mbouyer/weatherstation/hardware/images/vetus.jpg

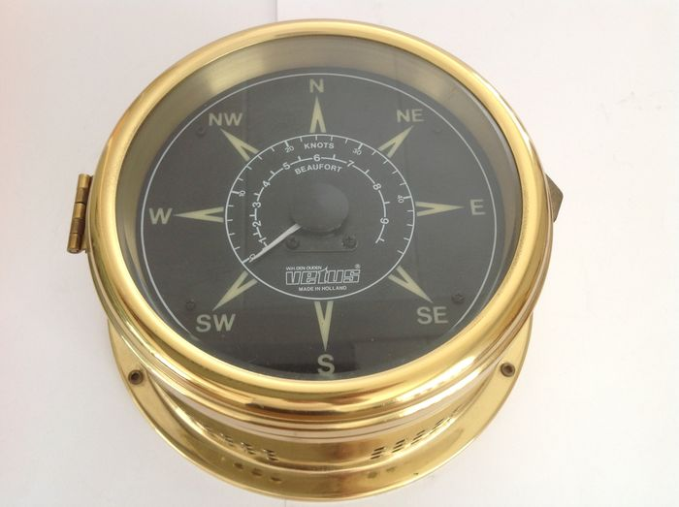
hardware/images/vetus.jpg
