mbouyer/weatherstation/README.md

# weatherstation
A home weather station with internet connectivity
