mbouyer/weatherstation/software/weewx/n2k_driver/readme.txt

n2k_driver - a driver monitoring a CAN bus
Copyright 2021 Manuel BOUYER
