mbouyer/weatherstation/hardware/capteur/CAD/1555CGY-pcb.dxf

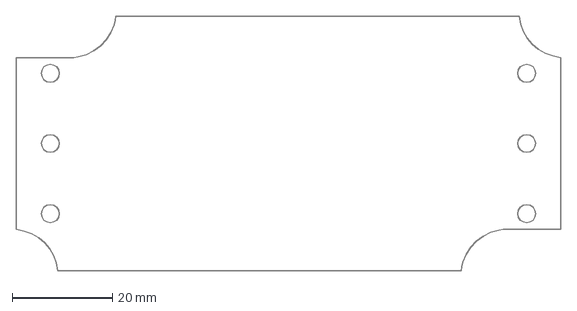
[picture p2: CAD file, 2022-03-15]
hardware/capteur/CAD/1555CGY-pcb.dxf
108.5 x 50.8 mm
