mbouyer/weatherstation/hardware/centrale/CAD/display-lock.stl

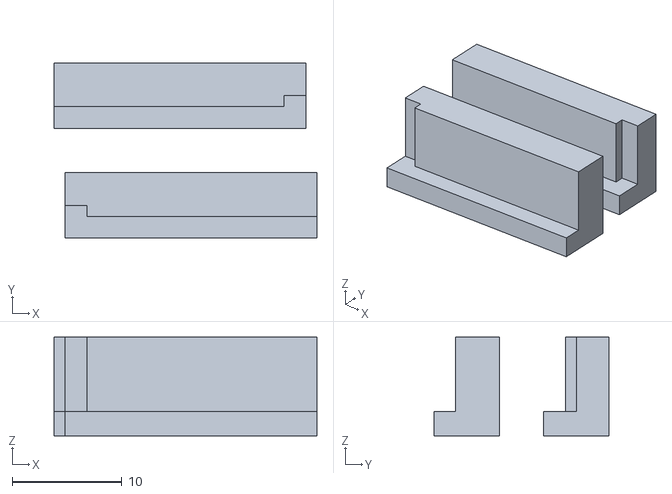
[picture p3: CAD file, 2022-04-14]
hardware/centrale/CAD/display-lock.stl
24.0 x 16.0 x 9.00
