mbouyer/weatherstation/hardware/coupleur/CAD/RX2007_S-5.dxf

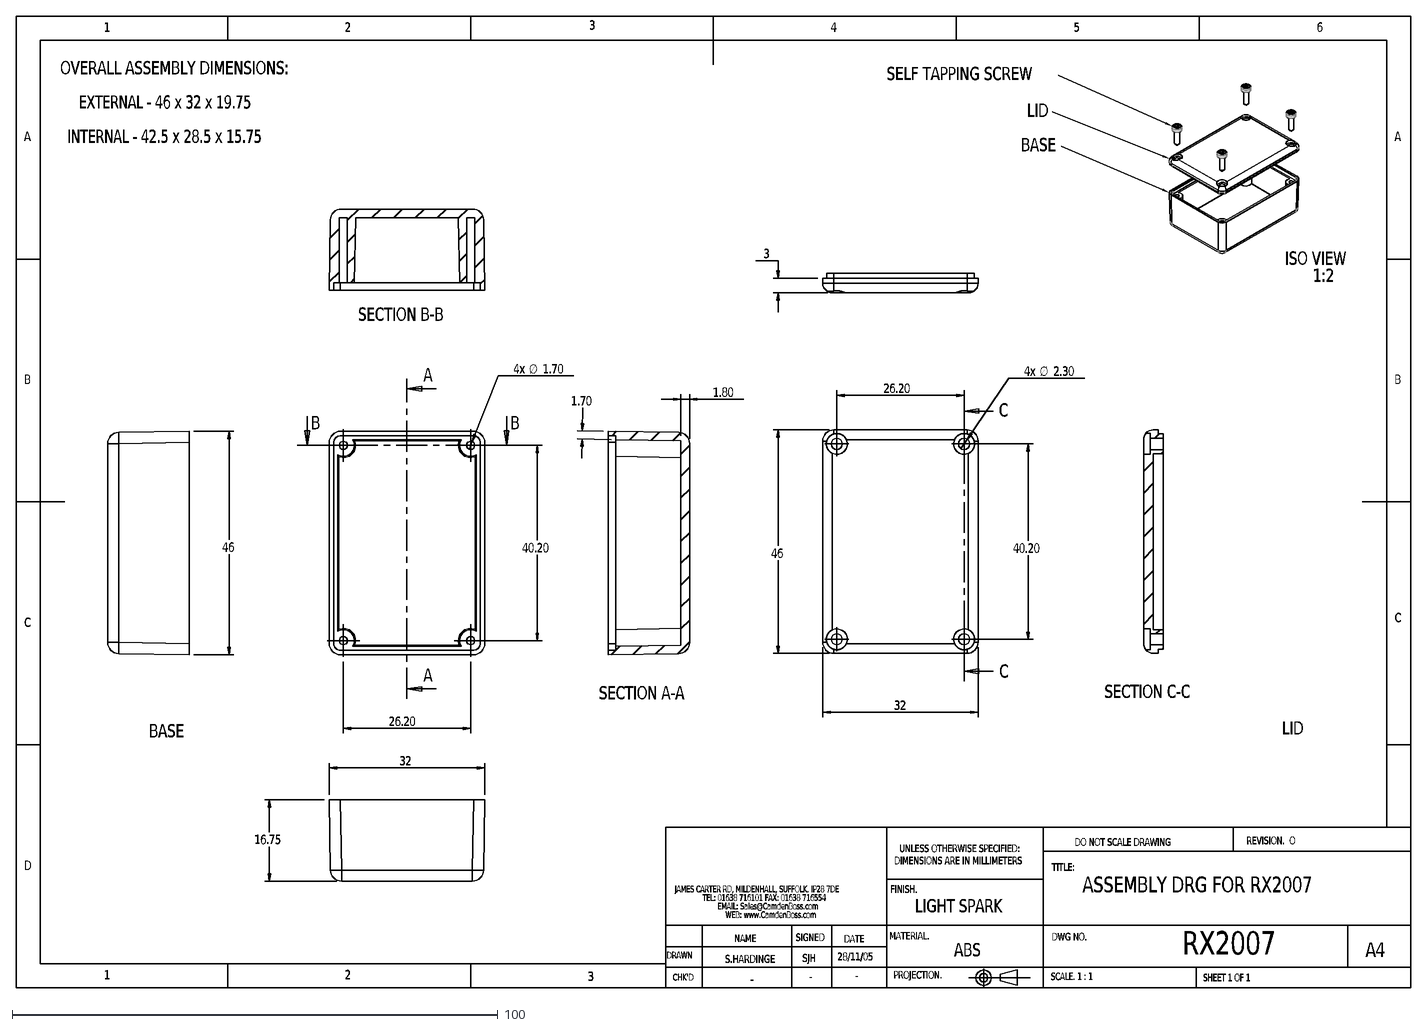
[picture p4: CAD file, 2021-04-18]
hardware/coupleur/CAD/RX2007_S-5.dxf
B
C
D
1
2
A
4
5
6
DRAWN
CHK'D
UNLESS OTHERWISE SPECIFIED:
DIMENSIONS ARE IN MILLIMETERS
FINISH.
NAME
SIGNED
DATE
MATERIAL.
DO NOT SCALE DRAWING
TITLE:
DWG NO.
SCALE. 1 : 1
SHEET 1 OF 1
A4
PROJECTION.
REVISION. O
RX2007
LIGHT SPARK
ABS
28/11/05
SJH
S.HARDINGE
-
ASSEMBLY DRG FOR RX2007
3
JAMES CARTER RD, MILDENHALL, SUFFOLK. IP28 7DE
TEL: 01638 716101 FAX: 01638 716554
EMAIL: Sales@CamdenBoss.com
WEB: www.CamdenBoss.com
40.20
4x
∅
1.70
26.20
16.75
32
46
BASE
2.30
1.80
SECTION A-A
SECTION B-B
OVERALL ASSEMBLY DIMENSIONS:
EXTERNAL - 46 x 32 x 19.75
INTERNAL - 42.5 x 28.5 x 15.75
SECTION C-C
LID
ISO VIEW
1:2
SELF TAPPING SCREW
