mbouyer/weatherstation/hardware/power/CAD/pcb.dxf

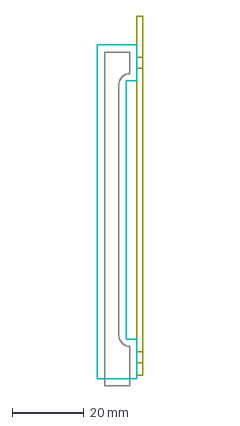
[picture p5: CAD file, 2021-05-04]
hardware/power/CAD/pcb.dxf
12.6 x 103.0 mm
