mbouyer/weatherstation/hardware/capteur/CAD/1555CGY-couvercle.dxf

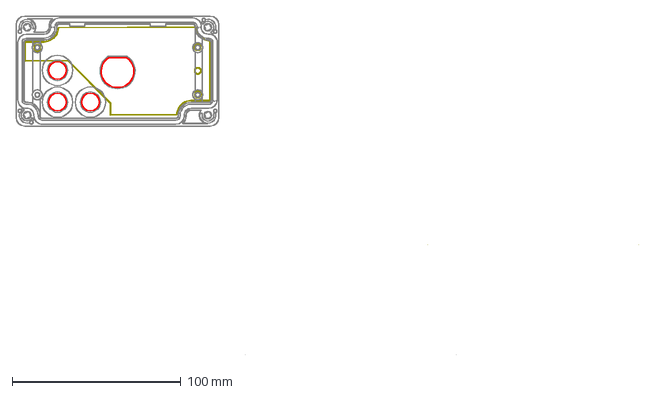
[picture p6: CAD file, 2021-05-07]
hardware/capteur/CAD/1555CGY-couvercle.dxf
368.6 x 200.4 mm
