mbouyer/weatherstation/hardware/centrale/CAD/display.stl

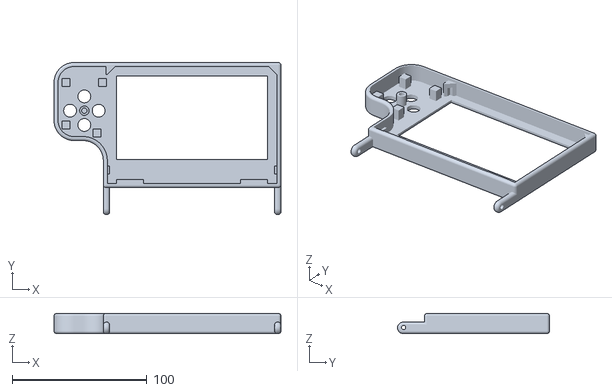
[picture p7: CAD file, 2022-04-13]
hardware/centrale/CAD/display.stl
168.6 x 112.9 x 15.0
