mbouyer/weatherstation/hardware/coupleur/CAD/RX2007_S-5-board.dxf

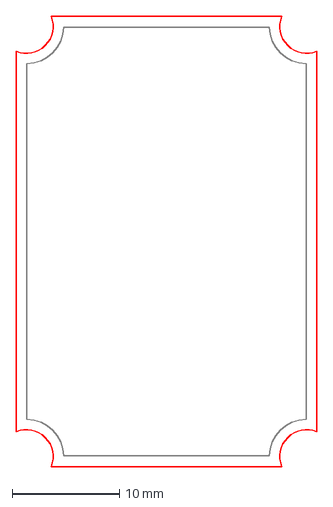
[picture p8: CAD file, 2021-04-18]
hardware/coupleur/CAD/RX2007_S-5-board.dxf
28.1 x 42.1 mm
