mbouyer/weatherstation/hardware/power/CAD/base.dxf

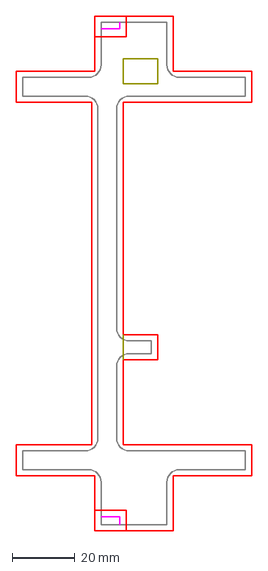
[picture p9: CAD file, 2021-05-04]
hardware/power/CAD/base.dxf
75.0 x 164.0 mm
