mbouyer/weatherstation/hardware/capteur/CAD/support-thermo-fn100.stl

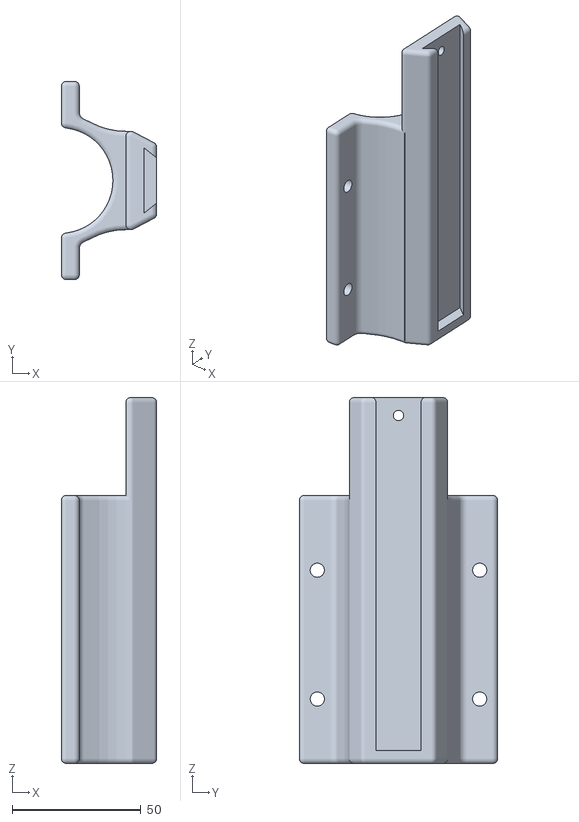
[picture p10: CAD file, 2021-04-18]
hardware/capteur/CAD/support-thermo-fn100.stl
37.0 x 77.0 x 142.0
