mbouyer/weatherstation/hardware/centrale/CAD/pcb.stl

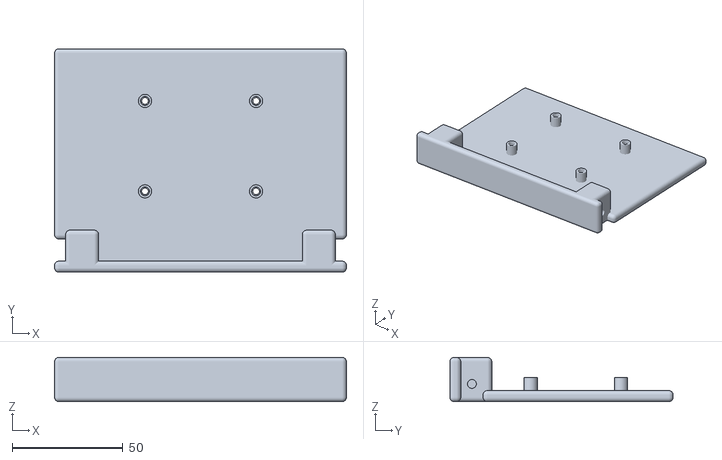
[picture p11: CAD file, 2022-04-11]
hardware/centrale/CAD/pcb.stl
132.0 x 101.0 x 20.0
