mbouyer/weatherstation/hardware/capteur/CAD/support-pluvio-fa30_10.stl

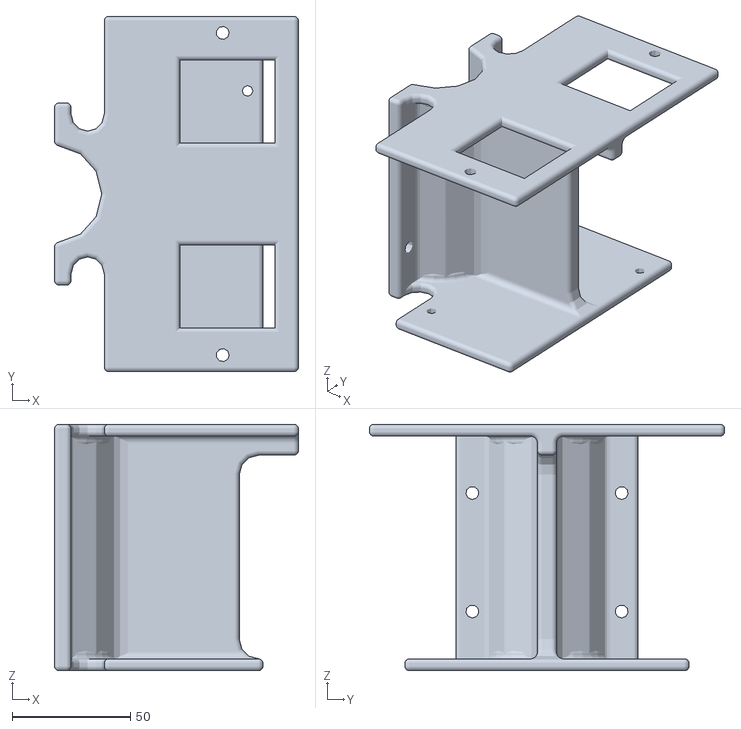
[picture p12: CAD file, 2021-04-18]
hardware/capteur/CAD/support-pluvio-fa30_10.stl
103.0 x 150.0 x 104.0
