mbouyer/weatherstation/hardware/centrale/CAD/PCB-mesures.dxf

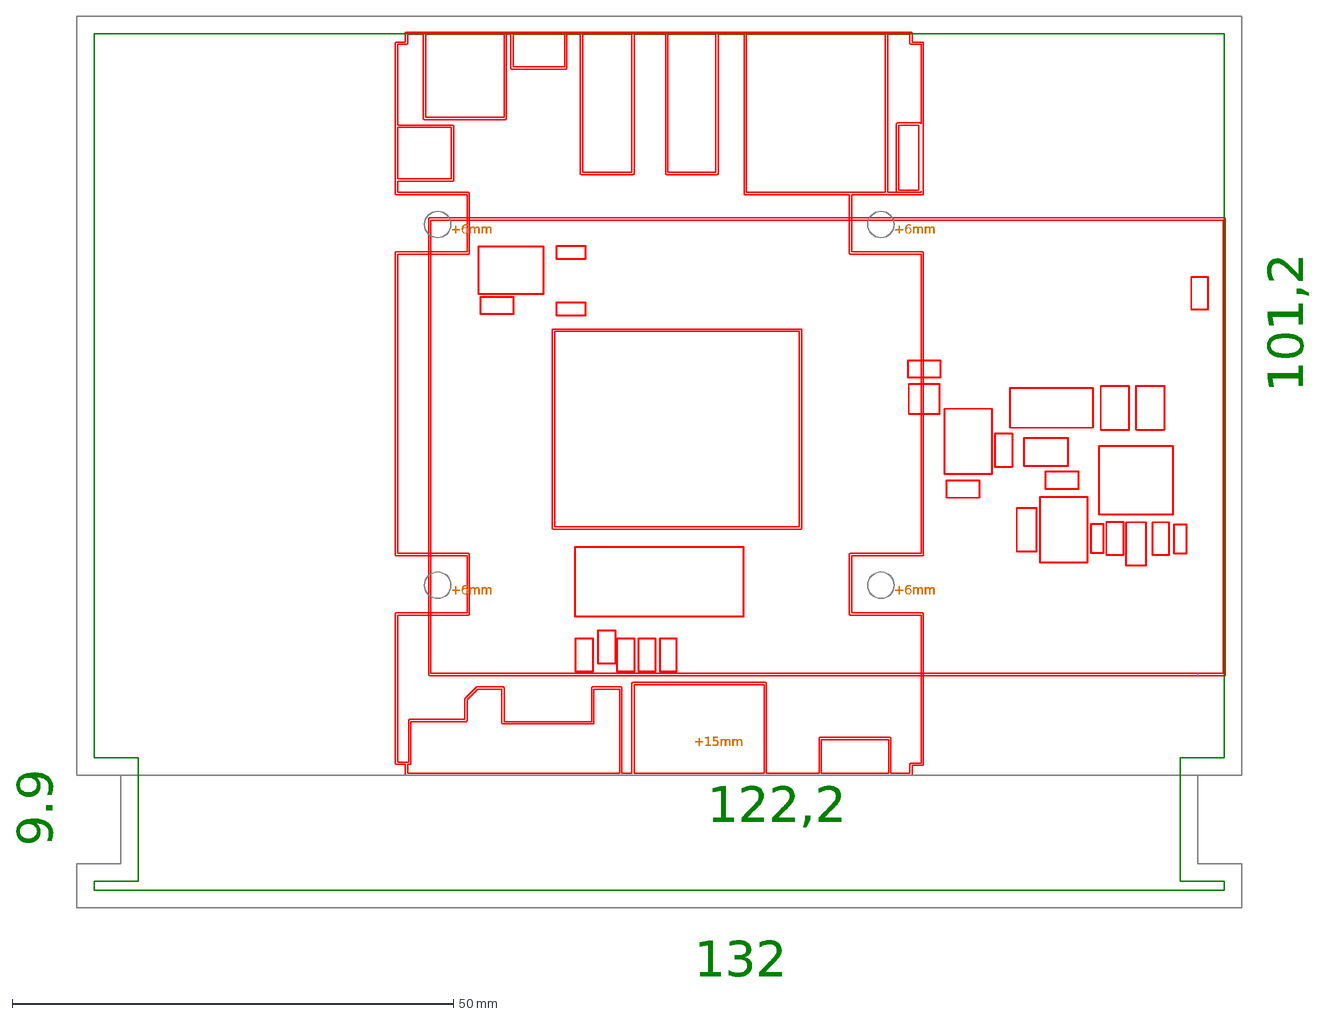
[picture p13: CAD file, 2022-04-11]
hardware/centrale/CAD/PCB-mesures.dxf
+6mm
+15mm
122,2
132
9.9
101,2
