mbouyer/weatherstation/hardware/capteur/CAD/enveloppe-tube-thermo.dxf

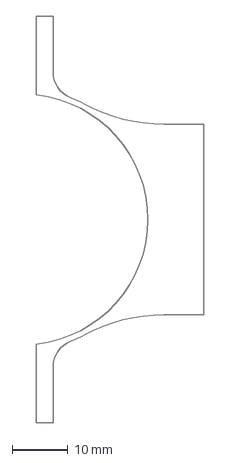
[picture p14: CAD file, 2021-04-18]
hardware/capteur/CAD/enveloppe-tube-thermo.dxf
30.0 x 73.0 mm
