mbouyer/weatherstation/hardware/capteur/CAD/support-thermo.dxf

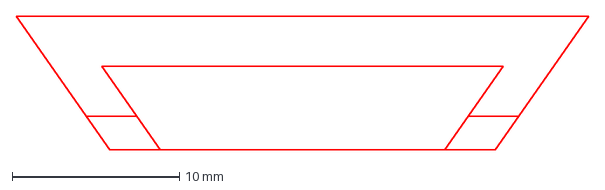
[picture p15: CAD file, 2021-04-18]
hardware/capteur/CAD/support-thermo.dxf
34.2 x 8.00 mm
