mbouyer/weatherstation/hardware/capteur/CAD/plaque-boitier.dxf

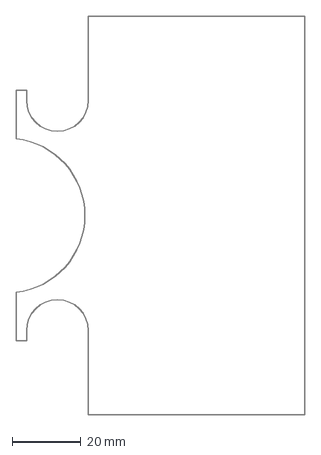
[picture p16: CAD file, 2021-04-18]
hardware/capteur/CAD/plaque-boitier.dxf
84.0 x 116.0 mm
