mbouyer/weatherstation/hardware/capteur/CAD/enveloppe-tube-pluvio.dxf

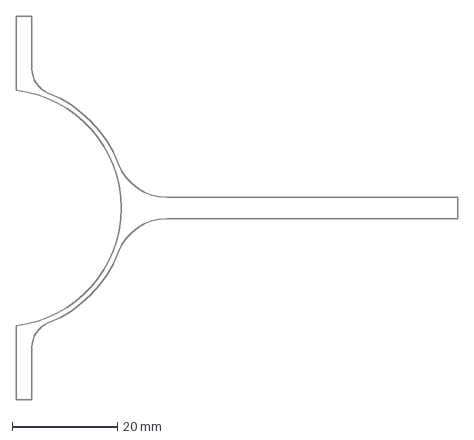
[picture p17: CAD file, 2021-04-18]
hardware/capteur/CAD/enveloppe-tube-pluvio.dxf
84.0 x 73.0 mm
