mbouyer/weatherstation/hardware/capteur/CAD/plaque-pluvio.dxf

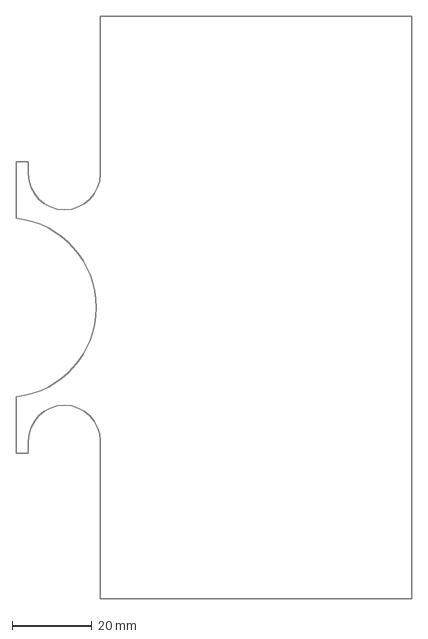
[picture p18: CAD file, 2021-04-18]
hardware/capteur/CAD/plaque-pluvio.dxf
99.0 x 146.0 mm
