mbouyer/weatherstation/(list of files, cad)

Other CAD files:
hardware/capteur/CAD/support-thermo-fn50.stl
hardware/centrale/CAD/PCB.dxf
hardware/centrale/CAD/display.dxf
