mbouyer/weatherstation/hardware/centrale/centrale.kicad_pcb

## KiCad design hardware/centrale/centrale.kicad_pcb (2023-04-15)

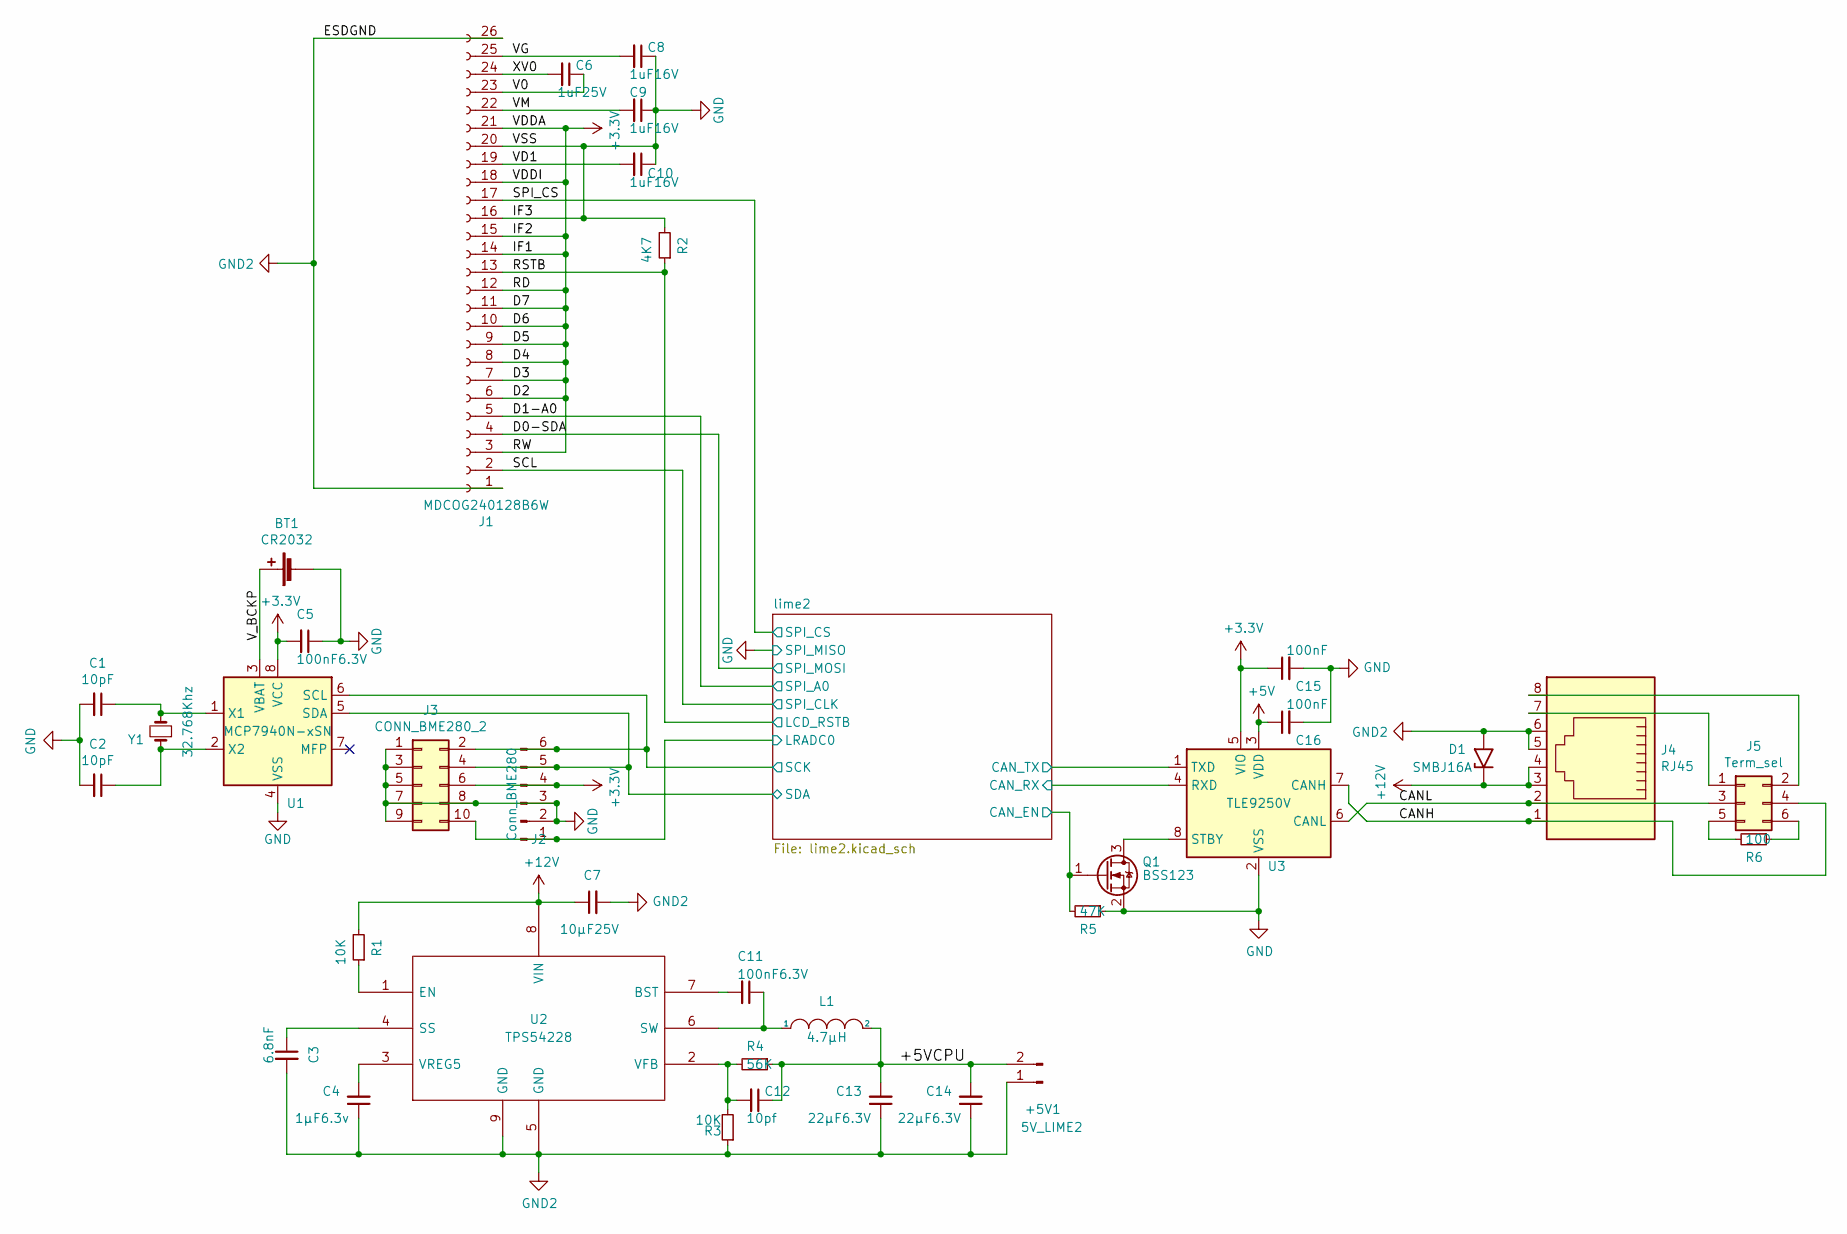
[picture p19: schematic centrale.kicad_sch, SHIELD]

Parts:
+5V1: 5V_LIME2; MC24356
BT1: CR2032; 1066
C1, C2: 10pF; C_0603_1608Metric_Pad1.08x0.95mm_HandSolder
C3: 6.8nF; C_0603_1608Metric_Pad1.08x0.95mm_HandSolder
C4: 1µF6.3v; C_0805_2012Metric_Pad1.18x1.45mm_HandSolder
C5, C11: 100nF6.3V; C_0805_2012Metric_Pad1.18x1.45mm_HandSolder
C6: 1uF25V; C_0805_2012Metric_Pad1.18x1.45mm_HandSolder
C7: 10µF25V; C_1210_3225Metric_Pad1.33x2.70mm_HandSolder
C8, C9, C10: 1uF16V; C_0805_2012Metric_Pad1.18x1.45mm_HandSolder
C12: 10pf; C_0603_1608Metric_Pad1.08x0.95mm_HandSolder
C13, C14: 22µF6.3V; C_1210_3225Metric_Pad1.33x2.70mm_HandSolder
C15, C16: 100nF; C_0805_2012Metric_Pad1.18x1.45mm_HandSolder
D1: SMBJ16A; D_SMB_Handsoldering
J1: MDCOG240128B6W; multicomp505110-2691
J2: Conn_BME280; JST_S6B-ZR-SM4A-TF(LF)(SN)
J3: CONN_BME280_2; CONN-TE-MICROMATCH-5X2-PTH-BOSS
J4: RJ45; RJ45_Amphenol_54602-x08_Horizontal
J5: Term_sel; PinHeader_2x03_P2.54mm_Vertical
L1: 4.7µH; L_TT_7.3x6.8
Q1: BSS123; SOT-23
R1, R3: 10K; R_1206_3216Metric_Pad1.30x1.75mm_HandSolder
R2: 4K7; R_0805_2012Metric_Pad1.20x1.40mm_HandSolder
R4: 56K; R_0805_2012Metric_Pad1.20x1.40mm_HandSolder
R5: 47K; R_0805_2012Metric_Pad1.20x1.40mm_HandSolder
R6: 100; R_0805_2012Metric_Pad1.20x1.40mm_HandSolder
U1: MCP7940N-xSN; SOIC-8_3.9x4.9mm_P1.27mm
U2: TPS54228; SOIC-8-1EP_3.9x4.9mm_P1.27mm_EP2.41x3.3mm
U3: TLE9250V; SOIC-8_3.9x4.9mm_P1.27mm
Y1: 32.768Khz; CMR200T

Connections:
+3.3V: C5.2, C15.1, J1.3, J1.6, J1.7, J1.8, J1.9, J1.10, J1.11, J1.12, J1.14, J1.15, J1.18, J1.21, J2.4, J3.6, U1.8 (VCC), U3.5 (VIO); also elsewhere on the board
+5V: C16.1, U3.3 (VDD); also elsewhere on the board
+12V: C7.1, D1.1 (A1), J4.3, J4.4, R1.2, U2.8 (VIN)
/+5VCPU: +5V1.2, C12.1, C13.2, C14.2, L1.2, R4.1
/CANH: J4.1, J5.4, U3.7 (CANH)
/CANL: J4.2, J5.3, U3.6 (CANL)
/D0-SDA: J1.4; also elsewhere on the board
/D1-A0: J1.5; also elsewhere on the board
/RSTB: J1.13, R2.1; also elsewhere on the board
/SCL: J1.2; also elsewhere on the board
/SPI_CS: J1.17; also elsewhere on the board
/V0: C6.1, J1.23
/VD1: C10.2, J1.19
/VG: C8.2, J1.25
/VM: C9.2, J1.22
/V_BCKP: BT1.1 (+), U1.3 (VBAT)
/XV0: C6.2, J1.24
/lime2/EMDC/LCD1_D21/ATADREQ/CAN_RX/EINT21/CSI1_D21/PH21: U3.4 (RXD); also elsewhere on the board
/lime2/ERXDV/LCD1_D20/ATAOE/CAN_TX/EINT20/CSI1_D20/PH20: U3.1 (TXD); also elsewhere on the board
/lime2/ERXERR/LCD1_D19/ATAD15/KP_OUT1/SMC_SDA/EINT19/CSI1_D19/PH19: Q1.1 (G), R5.2; also elsewhere on the board
/lime2/LRADC0: J2.1, J3.10; also elsewhere on the board
/lime2/TWI1_SCK/PB18: J2.6, J3.2, U1.6 (SCL); also elsewhere on the board
/lime2/TWI1_SDA/PB19: J2.5, J3.4, U1.5 (SDA); also elsewhere on the board
GND: BT1.2 (-), C1.2, C2.2, C5.1, C8.1, C9.1, C10.1, C15.2, C16.2, J1.16, J1.20, J2.2, J2.3, J3.1, J3.3, J3.5, J3.7, J3.8, J3.9, Q1.2 (S), R2.2, R5.1, U1.4 (VSS), U3.2 (VSS), U3.9 (VSS); also elsewhere on the board
GND2: +5V1.1, C3.2, C4.1, C7.2, C13.1, C14.1, D1.2 (A2), J1.1, J1.26, J4.5, J4.6, R3.1, U2.5 (GND), U2.9 (GND)
unnamed: C1.1, U1.1 (X1), Y1.2
unnamed: C2.1, U1.2 (X2), Y1.1
unnamed: C3.1, U2.4 (SS)
unnamed: C4.2, U2.3 (VREG5)
unnamed: C11.1, L1.1, U2.6 (SW)
unnamed: C11.2, U2.7 (BST)
unnamed: C12.2, R3.2, R4.2, U2.2 (VFB)
unnamed: J4.7, J5.1
unnamed: J4.8, J5.2
unnamed: J5.5, R6.2
unnamed: J5.6, R6.1
unnamed: Q1.3 (D), U3.8 (STBY)
unnamed: R1.1, U2.1 (EN)

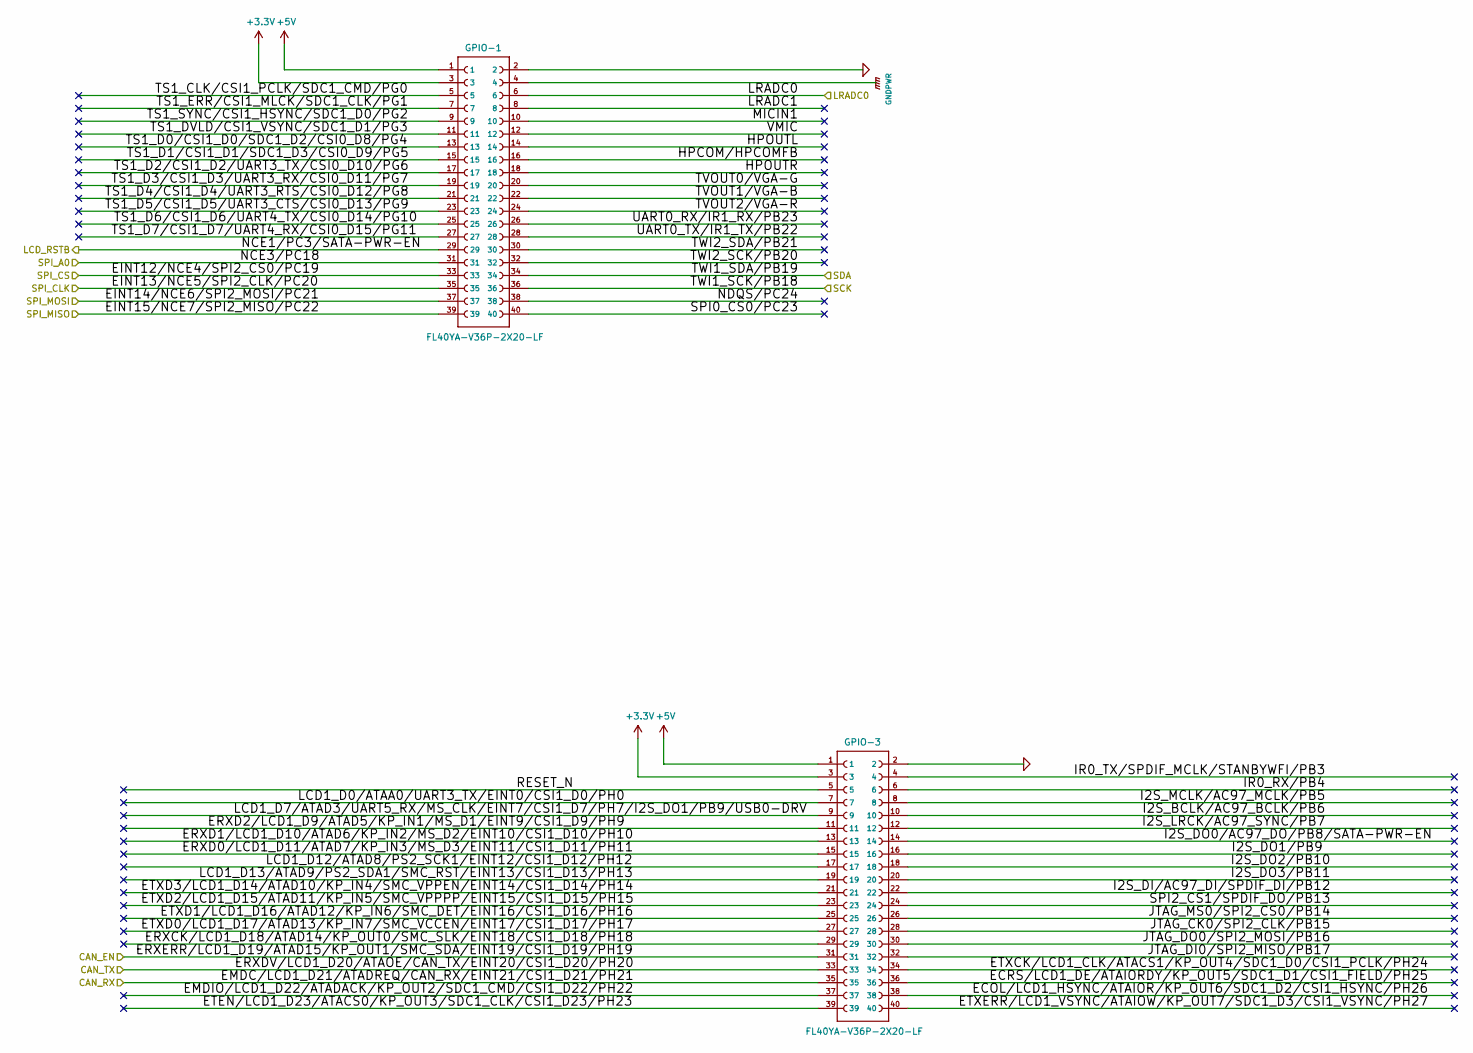
[picture p20: schematic lime2.kicad_sch]

Parts:
GPIO-1, GPIO-3: FL40YA-V36P-2X20-LF; A20_OLIMEXINO_LIME2_SHIELD_1-YA-V36P-2X20-LF

Connections:
+3.3V: GPIO-1.3, GPIO-3.3; also elsewhere on the board
+5V: GPIO-1.1, GPIO-3.1; also elsewhere on the board
/D0-SDA: GPIO-1.37; also elsewhere on the board
/D1-A0: GPIO-1.31; also elsewhere on the board
/RSTB: GPIO-1.29; also elsewhere on the board
/SCL: GPIO-1.35; also elsewhere on the board
/SPI_CS: GPIO-1.33; also elsewhere on the board
/lime2/ECOL/LCD1_HSYNC/ATAIOR/KP_OUT6/SDC1_D2/CSI1_HSYNC/PH26: GPIO-3.38
/lime2/ECRS/LCD1_DE/ATAIORDY/KP_OUT5/SDC1_D1/CSI1_FIELD/PH25: GPIO-3.36
/lime2/EMDC/LCD1_D21/ATADREQ/CAN_RX/EINT21/CSI1_D21/PH21: GPIO-3.35; also elsewhere on the board
/lime2/EMDIO/LCD1_D22/ATADACK/KP_OUT2/SDC1_CMD/CSI1_D22/PH22: GPIO-3.37
/lime2/ERXCK/LCD1_D18/ATAD14/KP_OUT0/SMC_SLK/EINT18/CSI1_D18/PH18: GPIO-3.29
/lime2/ERXD0/LCD1_D11/ATAD7/KP_IN3/MS_D3/EINT11/CSI1_D11/PH11: GPIO-3.15
/lime2/ERXD1/LCD1_D10/ATAD6/KP_IN2/MS_D2/EINT10/CSI1_D10/PH10: GPIO-3.13
/lime2/ERXD2/LCD1_D9/ATAD5/KP_IN1/MS_D1/EINT9/CSI1_D9/PH9: GPIO-3.11
/lime2/ERXDV/LCD1_D20/ATAOE/CAN_TX/EINT20/CSI1_D20/PH20: GPIO-3.33; also elsewhere on the board
/lime2/ERXERR/LCD1_D19/ATAD15/KP_OUT1/SMC_SDA/EINT19/CSI1_D19/PH19: GPIO-3.31; also elsewhere on the board
/lime2/ETEN/LCD1_D23/ATACS0/KP_OUT3/SDC1_CLK/CSI1_D23/PH23: GPIO-3.39
/lime2/ETXCK/LCD1_CLK/ATACS1/KP_OUT4/SDC1_D0/CSI1_PCLK/PH24: GPIO-3.34
/lime2/ETXD0/LCD1_D17/ATAD13/KP_IN7/SMC_VCCEN/EINT17/CSI1_D17/PH17: GPIO-3.27
/lime2/ETXD1/LCD1_D16/ATAD12/KP_IN6/SMC_DET/EINT16/CSI1_D16/PH16: GPIO-3.25
/lime2/ETXD2/LCD1_D15/ATAD11/KP_IN5/SMC_VPPPP/EINT15/CSI1_D15/PH15: GPIO-3.23
/lime2/ETXD3/LCD1_D14/ATAD10/KP_IN4/SMC_VPPEN/EINT14/CSI1_D14/PH14: GPIO-3.21
/lime2/ETXERR/LCD1_VSYNC/ATAIOW/KP_OUT7/SDC1_D3/CSI1_VSYNC/PH27: GPIO-3.40
/lime2/HPCOM/HPCOMFB: GPIO-1.16
/lime2/HPOUTL: GPIO-1.14
/lime2/HPOUTR: GPIO-1.18
/lime2/I2S_BCLK/AC97_BCLK/PB6: GPIO-3.10
/lime2/I2S_DI/AC97_DI/SPDIF_DI/PB12: GPIO-3.22
/lime2/I2S_DO0/AC97_DO/PB8/SATA-PWR-EN: GPIO-3.14
/lime2/I2S_DO1/PB9: GPIO-3.16
/lime2/I2S_DO2/PB10: GPIO-3.18
/lime2/I2S_DO3/PB11: GPIO-3.20
/lime2/I2S_LRCK/AC97_SYNC/PB7: GPIO-3.12
/lime2/I2S_MCLK/AC97_MCLK/PB5: GPIO-3.8
/lime2/IR0_RX/PB4: GPIO-3.6
/lime2/IR0_TX/SPDIF_MCLK/STANBYWFI/PB3: GPIO-3.4
/lime2/JTAG_CK0/SPI2_CLK/PB15: GPIO-3.28
/lime2/JTAG_DI0/SPI2_MISO/PB17: GPIO-3.32
/lime2/JTAG_DO0/SPI2_MOSI/PB16: GPIO-3.30
/lime2/JTAG_MS0/SPI2_CS0/PB14: GPIO-3.26
/lime2/LCD1_D0/ATAA0/UART3_TX/EINT0/CSI1_D0/PH0: GPIO-3.7
/lime2/LCD1_D7/ATAD3/UART5_RX/MS_CLK/EINT7/CSI1_D7/PH7/I2S_DO1/PB9/USB0-DRV: GPIO-3.9
/lime2/LCD1_D12/ATAD8/PS2_SCK1/EINT12/CSI1_D12/PH12: GPIO-3.17
/lime2/LCD1_D13/ATAD9/PS2_SDA1/SMC_RST/EINT13/CSI1_D13/PH13: GPIO-3.19
/lime2/LRADC0: GPIO-1.6; also elsewhere on the board
/lime2/LRADC1: GPIO-1.8
/lime2/MICIN1: GPIO-1.10
/lime2/NDQS/PC24: GPIO-1.38
/lime2/RESET_N: GPIO-3.5
/lime2/SPI0_CS0/PC23: GPIO-1.40
/lime2/SPI2_CS1/SPDIF_DO/PB13: GPIO-3.24
/lime2/TS1_CLK/CSI1_PCLK/SDC1_CMD/PG0: GPIO-1.5
/lime2/TS1_D0/CSI1_D0/SDC1_D2/CSI0_D8/PG4: GPIO-1.13
/lime2/TS1_D1/CSI1_D1/SDC1_D3/CSI0_D9/PG5: GPIO-1.15
/lime2/TS1_D2/CSI1_D2/UART3_TX/CSI0_D10/PG6: GPIO-1.17
/lime2/TS1_D3/CSI1_D3/UART3_RX/CSI0_D11/PG7: GPIO-1.19
/lime2/TS1_D4/CSI1_D4/UART3_RTS/CSI0_D12/PG8: GPIO-1.21
/lime2/TS1_D5/CSI1_D5/UART3_CTS/CSI0_D13/PG9: GPIO-1.23
/lime2/TS1_D6/CSI1_D6/UART4_TX/CSI0_D14/PG10: GPIO-1.25
/lime2/TS1_D7/CSI1_D7/UART4_RX/CSI0_D15/PG11: GPIO-1.27
/lime2/TS1_DVLD/CSI1_VSYNC/SDC1_D1/PG3: GPIO-1.11
/lime2/TS1_ERR/CSI1_MLCK/SDC1_CLK/PG1: GPIO-1.7
/lime2/TS1_SYNC/CSI1_HSYNC/SDC1_D0/PG2: GPIO-1.9
/lime2/TVOUT0/VGA-G: GPIO-1.20
/lime2/TVOUT1/VGA-B: GPIO-1.22
/lime2/TVOUT2/VGA-R: GPIO-1.24
/lime2/TWI1_SCK/PB18: GPIO-1.36; also elsewhere on the board
/lime2/TWI1_SDA/PB19: GPIO-1.34; also elsewhere on the board
/lime2/TWI2_SCK/PB20: GPIO-1.32
/lime2/TWI2_SDA/PB21: GPIO-1.30
/lime2/UART0_RX/IR1_RX/PB23: GPIO-1.26
/lime2/UART0_TX/IR1_TX/PB22: GPIO-1.28
/lime2/VMIC: GPIO-1.12
GND: GPIO-1.2, GPIO-1.39, GPIO-3.2; also elsewhere on the board
GNDPWR: GPIO-1.4

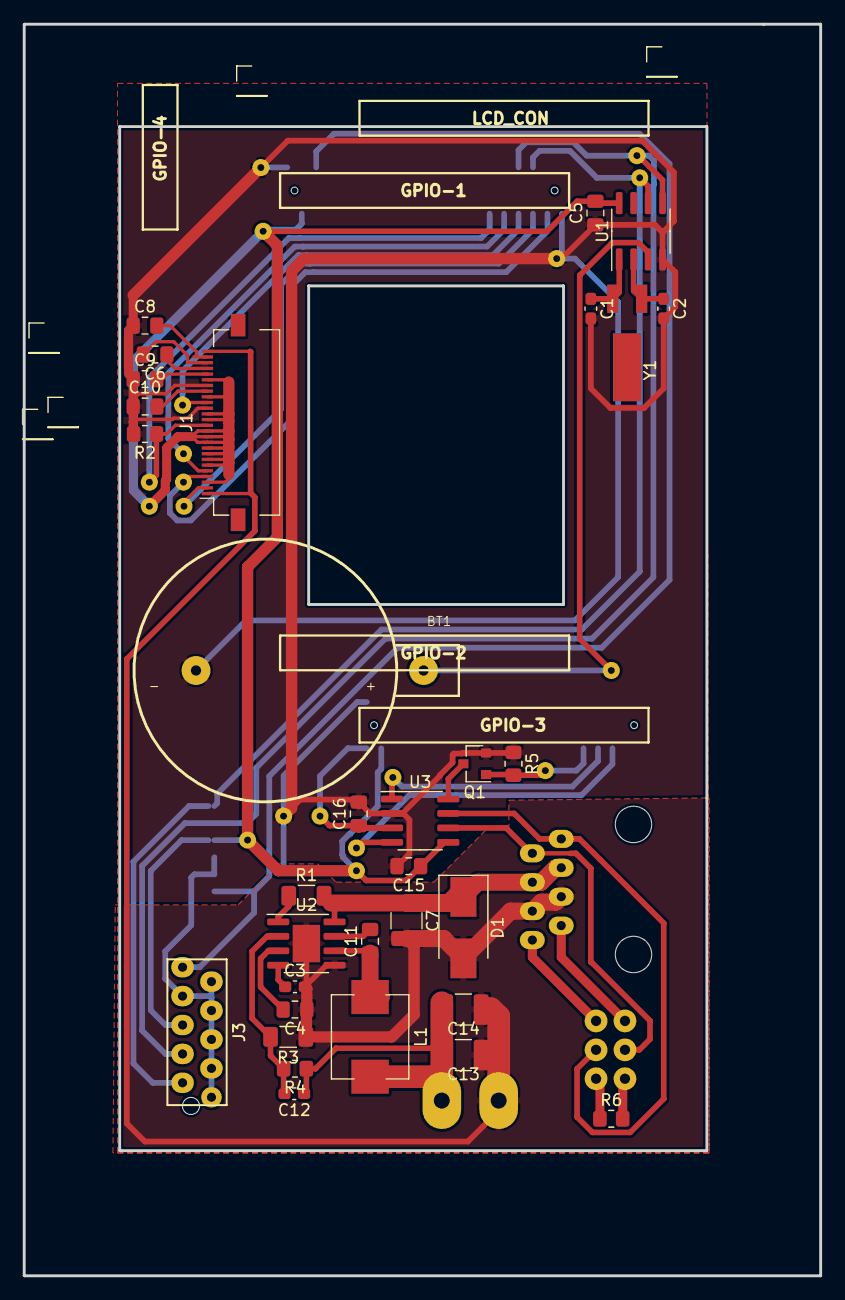
[picture p21: board centrale.kicad_pcb from above]

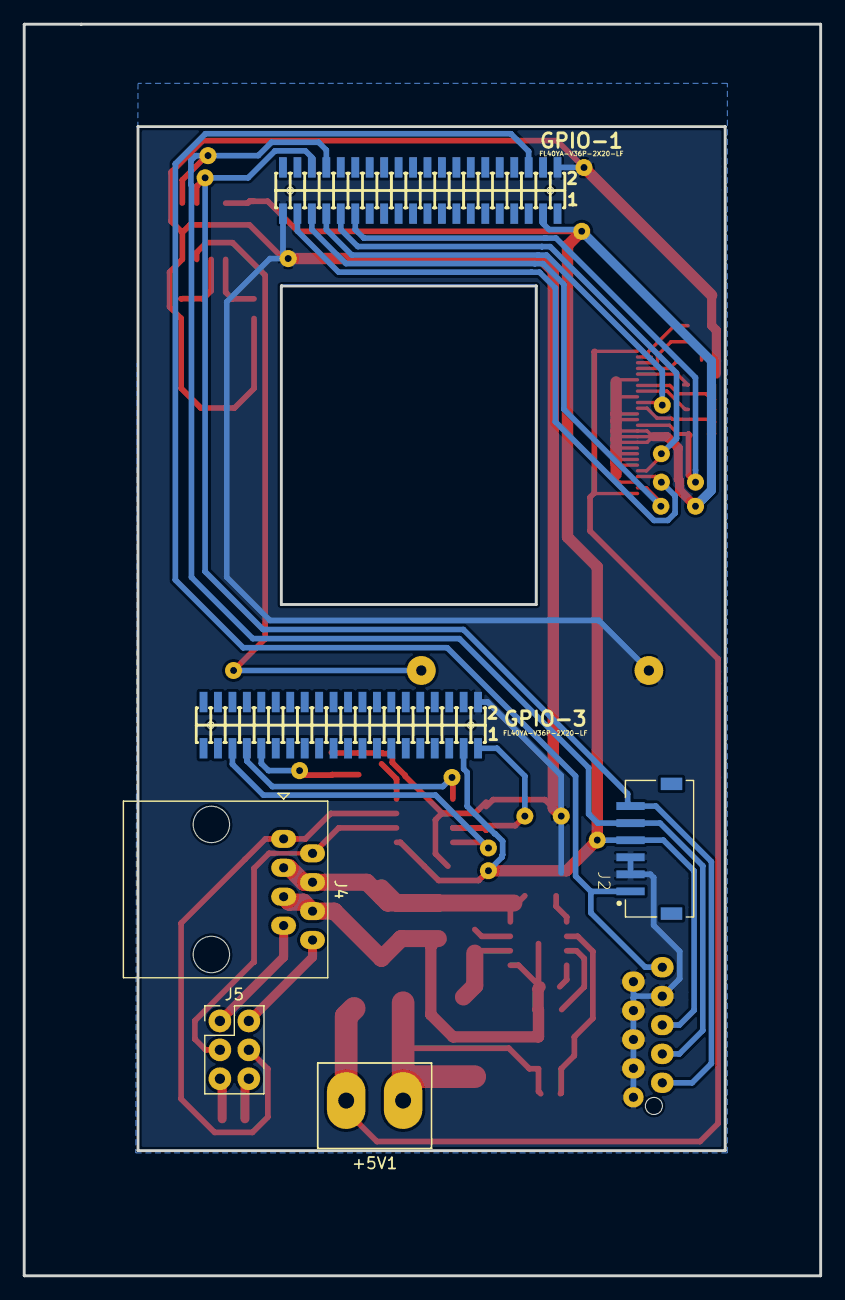
[picture p22: board centrale.kicad_pcb from below]

Board: 2 copper layers, 70.0 x 110.0 mm, 38 parts (6 on the bottom side), 38 nets.
