mbouyer/weatherstation/hardware/power/power.kicad_pcb

## KiCad design hardware/power/power.kicad_pcb (2023-03-14)

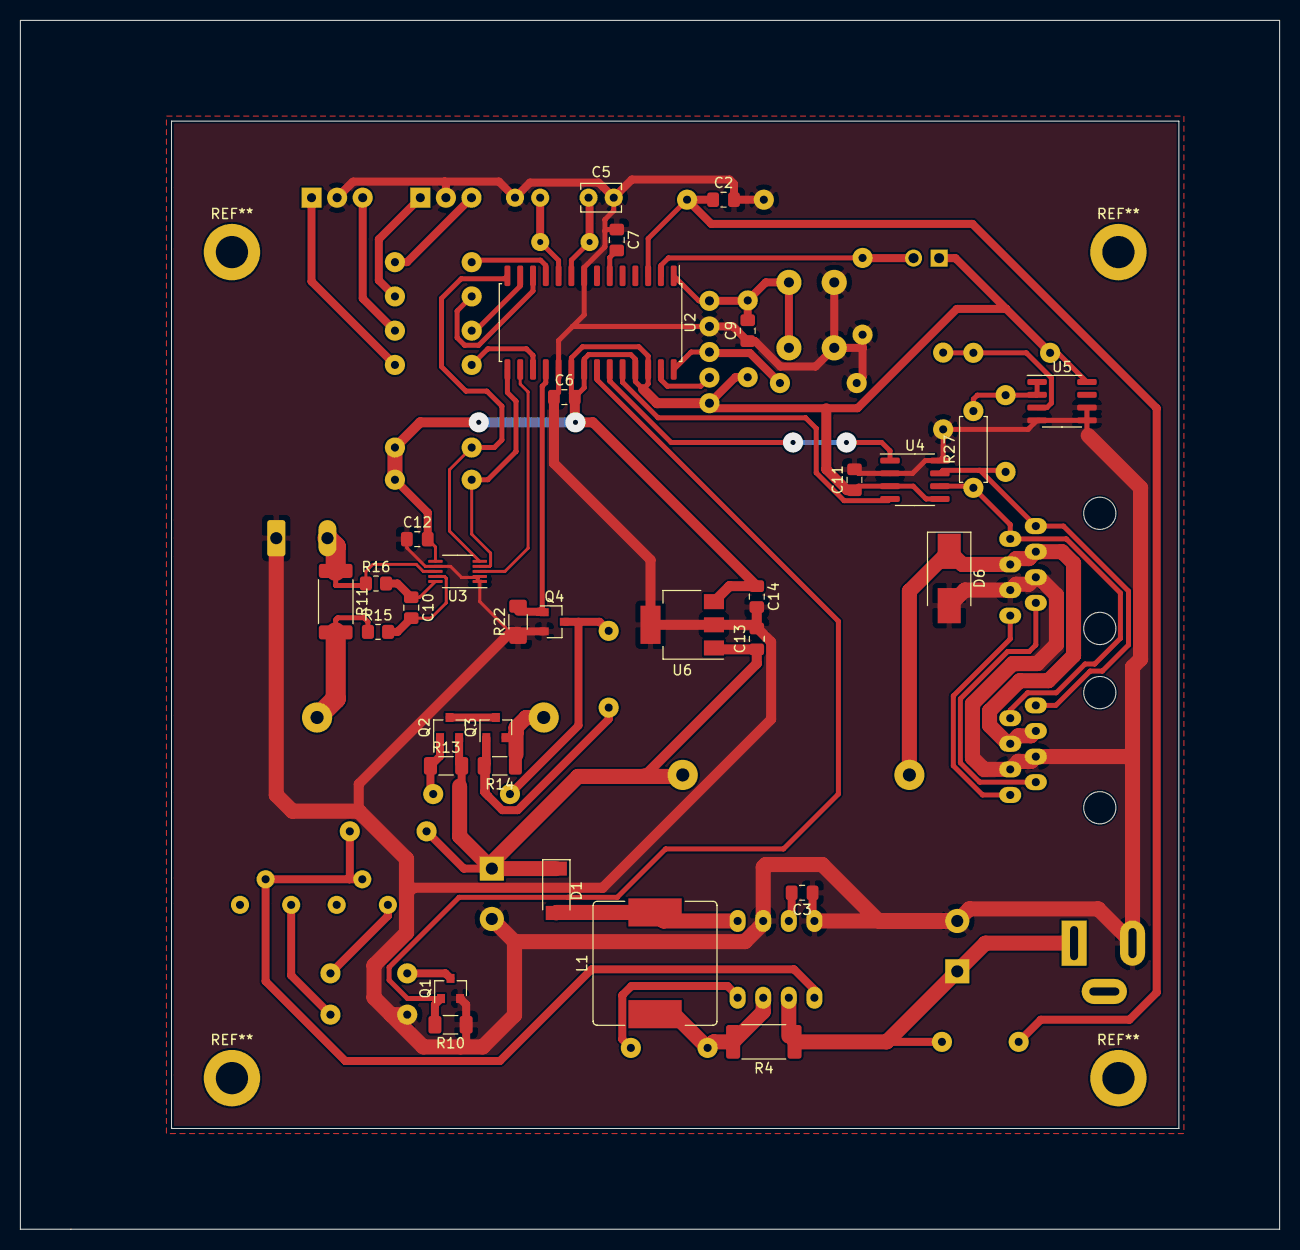
[picture p23: board power.kicad_pcb from above]

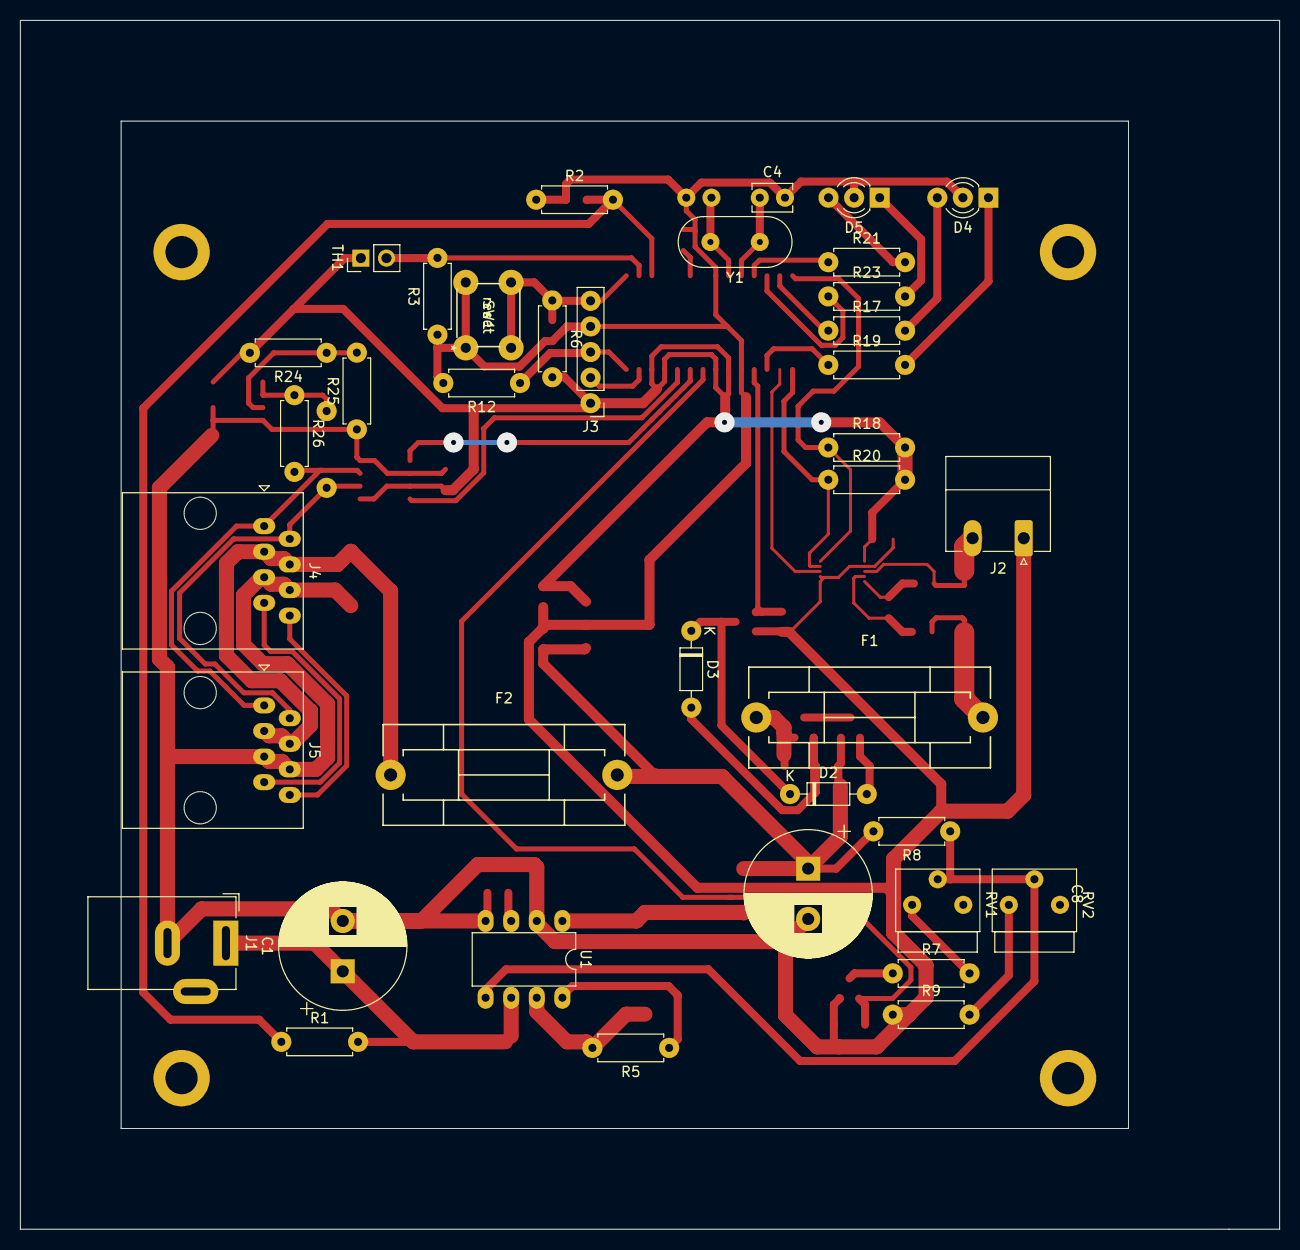
[picture p24: board power.kicad_pcb from below]

Board: 2 copper layers, 125.0 x 120.0 mm, 70 parts (38 on the bottom side), 51 nets.

Parts:
C1, C8: 1000µF; CP_Radial_D12.5mm_P5.00mm
C2, C6, C9, C11, C12: 100nF; C_0805_2012Metric_Pad1.18x1.45mm_HandSolder
C3, C10: 1nF; C_0805_2012Metric_Pad1.18x1.45mm_HandSolder
C4, C5: 22pF; C_Disc_D3.8mm_W2.6mm_P2.50mm
C7, C13, C14: 10uF; C_0805_2012Metric_Pad1.18x1.45mm_HandSolder
D1: D_Schottky; D_SOD-128
D2, D3: 1N4148; D_DO-35_SOD27_P7.62mm_Horizontal
D4, D5: LED; LED_D3.0mm-3
D6: SMBJ16A; D_SMB_Handsoldering
F1: 2A; Fuseholder5x20_horiz_SemiClosed_Casing10x22.5mm
F2: 1A; Fuseholder5x20_horiz_SemiClosed_Casing10x22.5mm
J1: Jack-DC; BarrelJack_Wuerth_6941xx301002
J2: BATT; PhoenixContact_MC_1,5_2-G-5.08_1x02_P5.08mm_Horizontal
J3: Conn_01x05_Male; PinHeader_1x05_P2.54mm_Vertical
J4, J5: RJ45; RJ45_Amphenol_54602-x08_Horizontal
L1: 220µH; L_Bourns_SRR1210A
Q1, Q4: BSS123; SOT-23
Q2, Q3: PMOS; SOT-23
R1, R3, R6, R12, R24, R25: 10K; R_Axial_DIN0207_L6.3mm_D2.5mm_P7.62mm_Horizontal
R2, R9: 1.8K; R_Axial_DIN0207_L6.3mm_D2.5mm_P7.62mm_Horizontal
R4: 0.22; R_2512_6332Metric_Pad1.40x3.35mm_HandSolder
R5: 180; R_Axial_DIN0207_L6.3mm_D2.5mm_P7.62mm_Horizontal
R7, R8: 18K7; R_Axial_DIN0207_L6.3mm_D2.5mm_P7.62mm_Horizontal
R10, R13, R14, R22: 10K; R_1206_3216Metric_Pad1.30x1.75mm_HandSolder
R11: 0.039; R_2512_6332Metric_Pad1.40x3.35mm_HandSolder
R15, R16: 10; R_0805_2012Metric_Pad1.20x1.40mm_HandSolder
R17, R19, R21, R23, R26, R27: 330; R_Axial_DIN0207_L6.3mm_D2.5mm_P7.62mm_Horizontal
R18, R20: 4K7; R_Axial_DIN0207_L6.3mm_D2.5mm_P7.62mm_Horizontal
RV1: 100K; Potentiometer_Bourns_3339S_Horizontal
RV2: 500; Potentiometer_Bourns_3339S_Horizontal
SW1: reset; 1825910-7
TH1: NTC10K; PinHeader_1x02_P2.54mm_Vertical
U1: MC33063AP; DIP-8_W7.62mm
U2: PIC18F26K80_ISS; SOIC-28W_7.5x17.9mm_P1.27mm
U3: INA226; VSSOP-10_3x3mm_P0.5mm
U4: MCP2542FDxMF; SOIC-8_3.9x4.9mm_P1.27mm
U5: LM358; SOIC-8_3.9x4.9mm_P1.27mm
U6: uA7805; SOT-223-3_TabPin2
Y1: 10Mhz; Crystal_HC18-U_Vertical

Connections:
+5V: C6.2, C11.1, C12.2, C14.1, J3.1, R6.2, R18.2, R20.2, R24.2, TH1.1, U2.20, U2.21, U2.25, U2.26, U3.6, U4.3, U4.5, U5.8, U6.3
+12V: C8.1, C13.1, D1.1, F2.2, Q2.2, R8.2, R13.2, U6.1
/+BATT: J2.2, R11.1, R16.1, U3.8
/ALRT: U2.16, U3.3
/BATT_ON: Q4.1, R22.2, U2.18
/B_CHRG: Q1.1, R10.2, U2.22
/CANH: J4.1, J5.1, R26.2, U4.7
/CANL: J4.2, J5.2, R27.1, U4.6
/CANRX: U2.24, U4.4
/CANTX: U2.23, U4.1
/MCLR: C9.2, J3.5, R6.1, SW1.3, SW1.4, U2.1
/PGC: J3.2, U2.27
/PGD: J3.3, R12.1, U2.28
/PS_OK: C2.1, R1.1, R2.2, U2.3
/SCL: R18.1, U2.14, U3.5
/SDA: R20.1, U2.15, U3.4
GND: C1.2, C2.2, C3.1, C4.2, C5.2, C6.1, C7.1, C8.2, C9.1, C11.2, C12.1, C13.2, C14.2, D4.2, D5.2, D6.2, J1.2, J2.1, J3.4, J4.5, J4.6, J5.5, J5.6, Q1.2, Q4.2, R2.1, R3.1, R9.1, R10.1, R12.2, R22.1, R25.1, SW1.1, SW1.2, U1.2, U1.4, U2.8, U2.19, U3.1, U3.2, U3.7, U4.2, U4.8, U5.4, U5.5, U5.6, U6.2
unnamed: C1.1, J1.1, R1.2, R4.1, U1.6
unnamed: C3.2, U1.3
unnamed: C4.1, U2.10, Y1.1
unnamed: C5.1, U2.9, Y1.2
unnamed: C7.2, U2.6
unnamed: C10.1, R16.2, U3.10
unnamed: C10.2, R15.2, U3.9
unnamed: D1.2, L1.2, U1.1
unnamed: D2.1, D3.1, Q4.3
unnamed: D2.2, Q2.1, R13.1
unnamed: D3.2, Q3.1, R14.2
unnamed: D4.1, R19.2
unnamed: D4.3, R17.2
unnamed: D5.1, R23.2
unnamed: D5.3, R21.2
unnamed: D6.1, F2.1, J4.3, J4.4, J5.3, J5.4
unnamed: F1.1, Q3.2, R14.1
unnamed: F1.2, R11.2, R15.1
unnamed: J4.7, J5.7
unnamed: J4.8, J5.8
unnamed: L1.1, R4.2, R5.2, U1.7
unnamed: Q1.3, R7.1
unnamed: Q2.3, Q3.3
unnamed: R3.2, TH1.2, U2.2
unnamed: R5.1, U1.8
unnamed: R7.2, RV1.3
unnamed: R8.1, RV1.2, RV2.2, U1.5
unnamed: R9.2, RV2.3
unnamed: R17.1, U2.13
unnamed: R19.1, U2.17
unnamed: R21.1, U2.11
unnamed: R23.1, U2.12
unnamed: R24.1, R25.2, U5.3
unnamed: R26.1, R27.2, U5.1, U5.2
