mbouyer/weatherstation/hardware/vetus/vetus.kicad_pcb

## KiCad design hardware/vetus/vetus.kicad_pcb (2023-03-14)

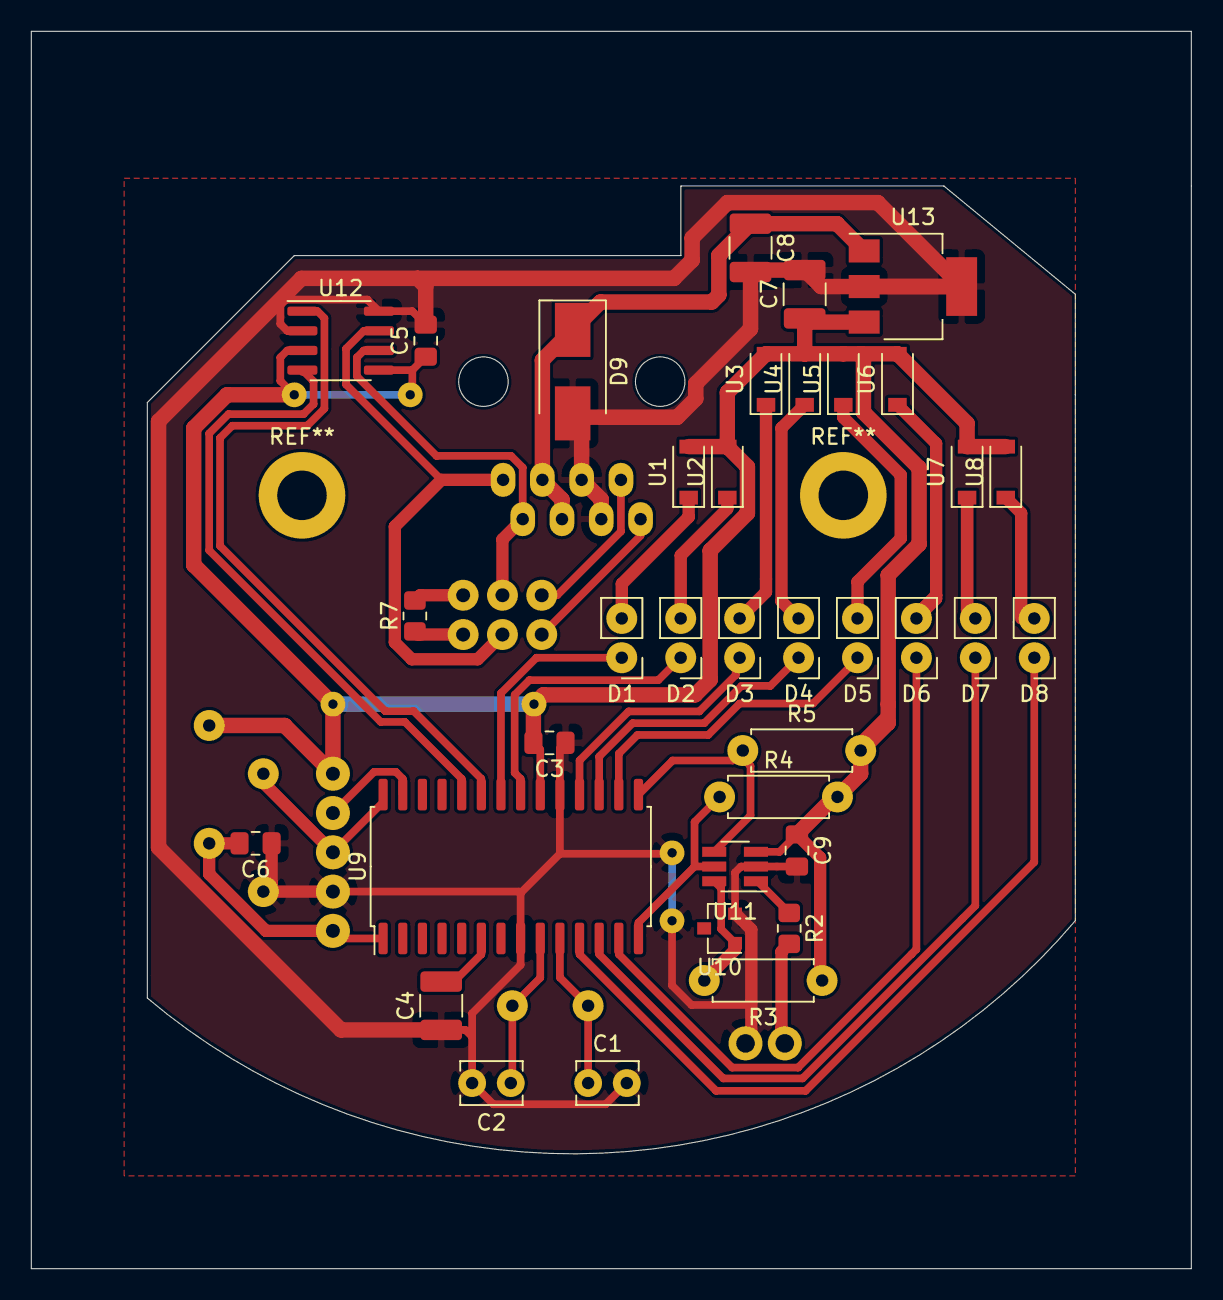
[picture p25: board vetus.kicad_pcb from above]

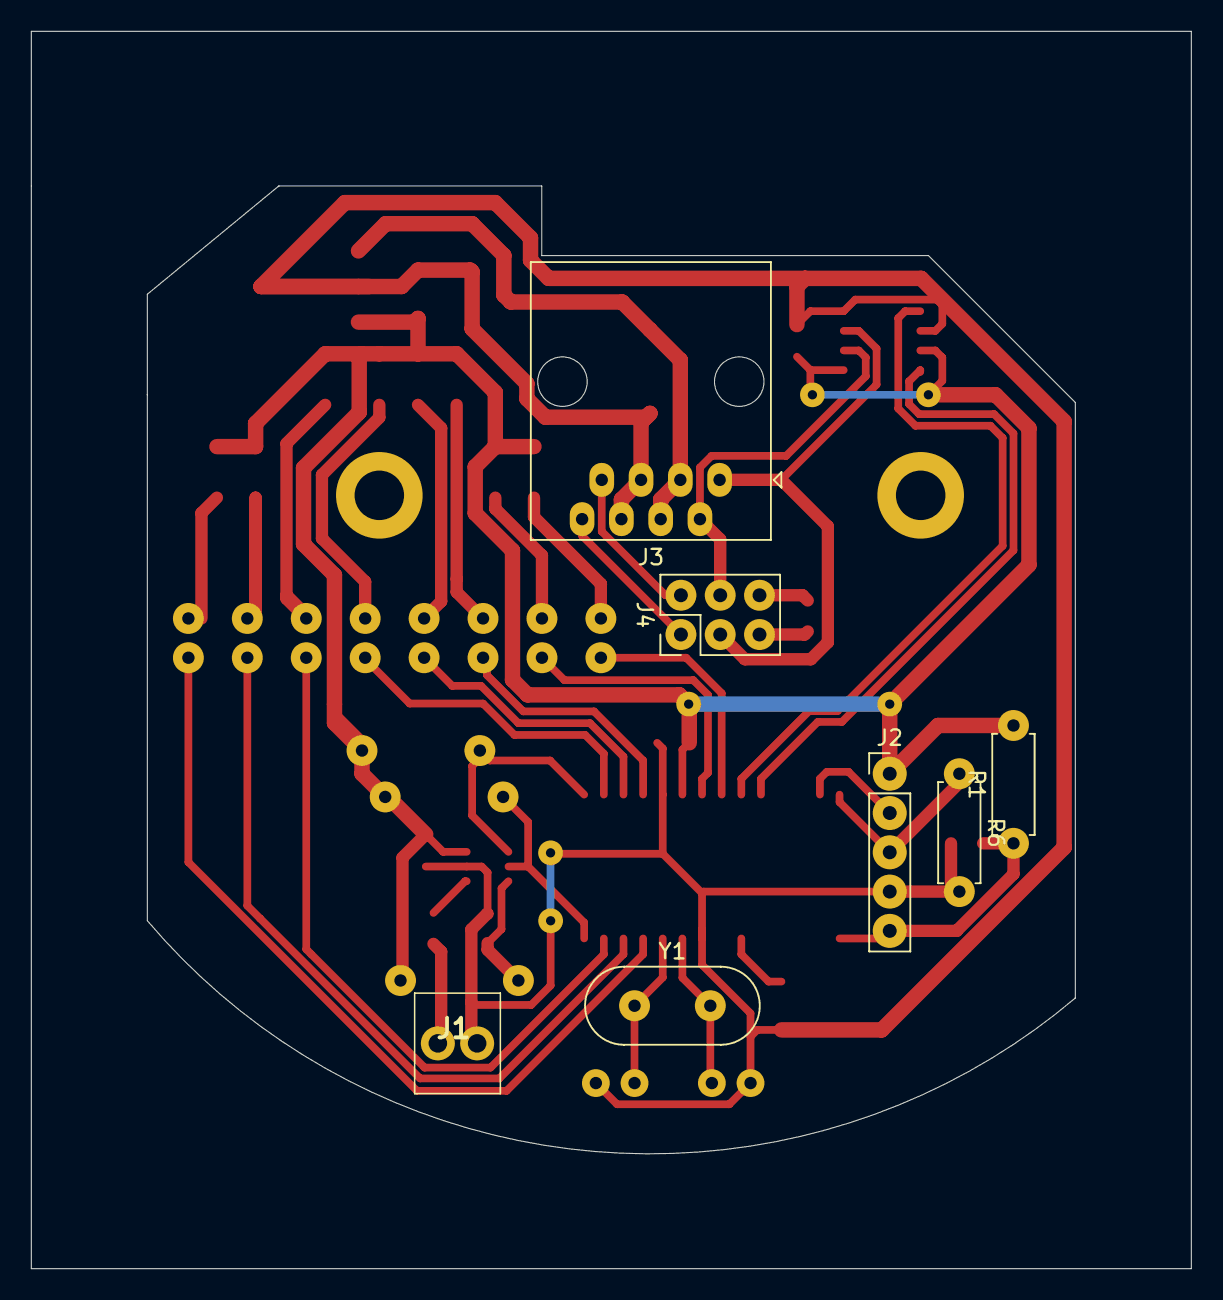
[picture p26: board vetus.kicad_pcb from below]

Board: 2 copper layers, 75.0 x 80.0 mm, 43 parts (7 on the bottom side), 38 nets.

Parts:
C1, C2: 22pF; C_Disc_D3.8mm_W2.6mm_P2.50mm
C3, C5, C6, C9: 100nF; C_0805_2012Metric_Pad1.18x1.45mm_HandSolder
C4, C7, C8: 10uF; C_1210_3225Metric_Pad1.33x2.70mm_HandSolder
D1: N; PinHeader_1x02_P2.54mm_Vertical
D2: NE; PinHeader_1x02_P2.54mm_Vertical
D3: E; PinHeader_1x02_P2.54mm_Vertical
D4: SE; PinHeader_1x02_P2.54mm_Vertical
D5: S; PinHeader_1x02_P2.54mm_Vertical
D6: SW; PinHeader_1x02_P2.54mm_Vertical
D7: W; PinHeader_1x02_P2.54mm_Vertical
D8: NW; PinHeader_1x02_P2.54mm_Vertical
D9: SMBJ16A; D_SMB_Handsoldering
J1: anemo; 282834-2_1
J2: Conn_01x05_Male; PinHeader_1x05_P2.54mm_Vertical
J3: RJ45; RJ45_Amphenol_54602-x08_Horizontal
J4: Term_sel; PinHeader_2x03_P2.54mm_Vertical
R1, R6: 10K; R_Axial_DIN0207_L6.3mm_D2.5mm_P7.62mm_Horizontal
R2: 1K74; R_0805_2012Metric_Pad1.20x1.40mm_HandSolder
R3, R4, R5: 4K7; R_Axial_DIN0207_L6.3mm_D2.5mm_P7.62mm_Horizontal
R7: 100; R_0805_2012Metric_Pad1.20x1.40mm_HandSolder
U1, U2, U3, U4, U5, U6, U7, U8: NSI45020T1G; D_SOD-123
U9: PIC18F26K80_ISS; SOIC-28W_7.5x17.9mm_P1.27mm
U10: LM4040DBZ-2.0; SOT-23
U11: MCP4706; SOT-23-6_Handsoldering
U12: MCP2542FDxMF; SOIC-8_3.9x4.9mm_P1.27mm
U13: uA7805; SOT-223-3_TabPin2
Y1: 10Mhz; Crystal_HC18-U_Vertical

Connections:
+5V: C3.2, C5.1, C7.1, C9.1, J2.1, R1.2, R3.1, R4.2, R5.2, U1.2, U2.2, U3.2, U4.2, U5.2, U6.2, U7.2, U8.2, U9.20, U11.3, U12.3, U12.5, U13.3
/+12V: C8.1, D9.1, J3.3, J3.4, U13.1
/CANH: J3.1, J4.3, U12.7
/CANL: J3.2, J4.4, U12.6
/CANRX: U9.24, U12.4
/CANTX: U9.23, U12.1
/E: D3.1, U9.18
/MCLR: C6.2, J2.5, R1.1, U9.1
/N: D1.1, U9.22
/NE: D2.1, U9.21
/NW: D8.1, U9.11
/PGC: J2.2, U9.27
/PGD: J2.3, R6.1, U9.28
/S: D5.1, U9.16
/SCL: R4.1, U9.14, U11.5
/SDA: R5.1, U9.15, U11.4
/SE: D4.1, U9.17
/SW: D6.1, U9.13
/W: D7.1, U9.12
GND: C1.2, C2.2, C3.1, C4.1, C5.2, C6.1, C7.2, C8.2, C9.2, D9.2, J1.2, J2.4, J3.5, J3.6, R6.2, U9.8, U9.19, U10.2, U11.2, U12.2, U12.8, U13.2
unnamed: C1.1, U9.10, Y1.1
unnamed: C2.1, U9.9, Y1.2
unnamed: C4.2, U9.6
unnamed: D1.2, U1.1
unnamed: D2.2, U2.1
unnamed: D3.2, U3.1
unnamed: D4.2, U4.1
unnamed: D5.2, U5.1
unnamed: D6.2, U6.1
unnamed: D7.2, U7.1
unnamed: D8.2, U8.1
unnamed: J1.1, R2.2
unnamed: J3.7, J4.2
unnamed: J3.8, J4.1
unnamed: J4.5, R7.1
unnamed: J4.6, R7.2
unnamed: R2.1, U11.1
unnamed: R3.2, U10.1, U11.6
