mbouyer/weatherstation/hardware/centrale/keys.kicad_pcb

## KiCad design hardware/centrale/keys.kicad_pcb (2023-03-14)

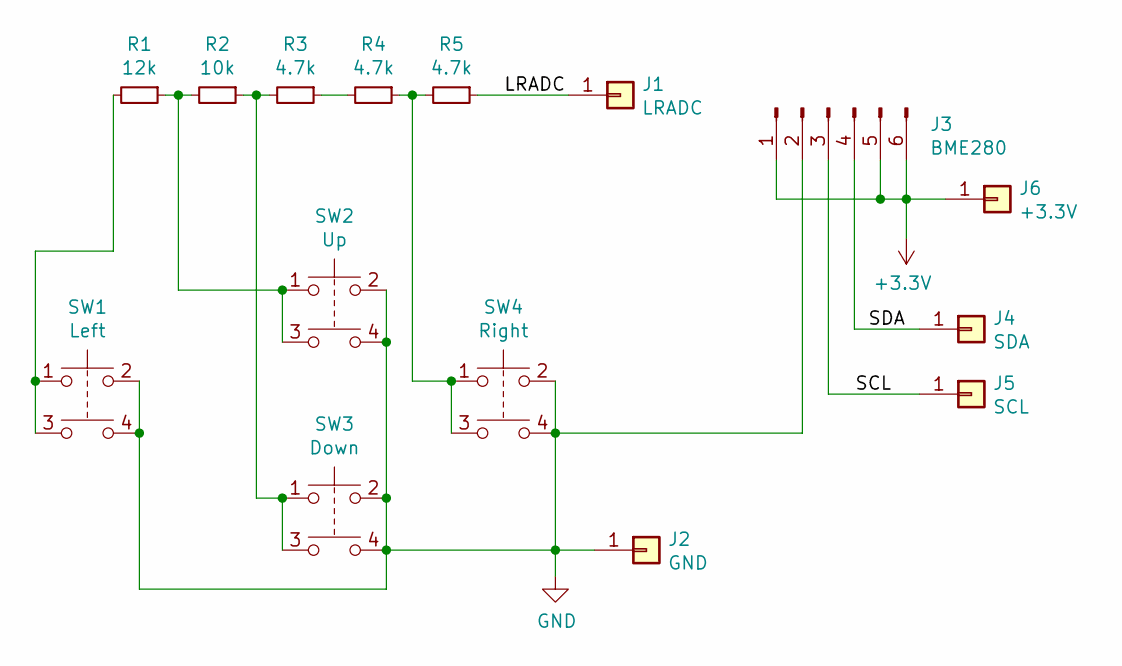
[picture p27: schematic keys.kicad_sch]

Parts:
J1: LRADC; SolderWire-0.1sqmm_1x01_D0.4mm_OD1mm_Relief
J2: GND; SolderWire-0.1sqmm_1x01_D0.4mm_OD1mm_Relief
J3: BME280; PinHeader_1x06_P2.54mm_Vertical
J4: SDA; SolderWire-0.1sqmm_1x01_D0.4mm_OD1mm_Relief
J5: SCL; SolderWire-0.1sqmm_1x01_D0.4mm_OD1mm_Relief
J6: +3.3V; SolderWire-0.1sqmm_1x01_D0.4mm_OD1mm_Relief
R1: 12k; R_0805_2012Metric_Pad1.20x1.40mm_HandSolder
R2: 10k; R_0805_2012Metric_Pad1.20x1.40mm_HandSolder
R3, R4, R5: 4.7k; R_0805_2012Metric_Pad1.20x1.40mm_HandSolder
SW1: Left; Push_E-Switch_KS01Q01
SW2: Up; Push_E-Switch_KS01Q01
SW3: Down; Push_E-Switch_KS01Q01
SW4: Right; Push_E-Switch_KS01Q01

Connections:
+3V3: J3.1, J3.5, J3.6, J6.1
/LRADC: J1.1, R5.1
/SCL: J3.3, J5.1
/SDA: J3.4, J4.1
GND: J2.1, J3.2, SW1.2, SW1.4, SW2.2, SW2.4, SW3.2, SW3.4, SW4.2, SW4.4
unnamed: R1.1, R2.2, SW2.1, SW2.3
unnamed: R1.2, SW1.1, SW1.3
unnamed: R2.1, R3.2, SW3.1, SW3.3
unnamed: R3.1, R4.2
unnamed: R4.1, R5.2, SW4.1, SW4.3
