mbouyer/weatherstation/hardware/centrale/keys.kicad_pcb

## KiCad design hardware/centrale/keys.kicad_pcb (continued)

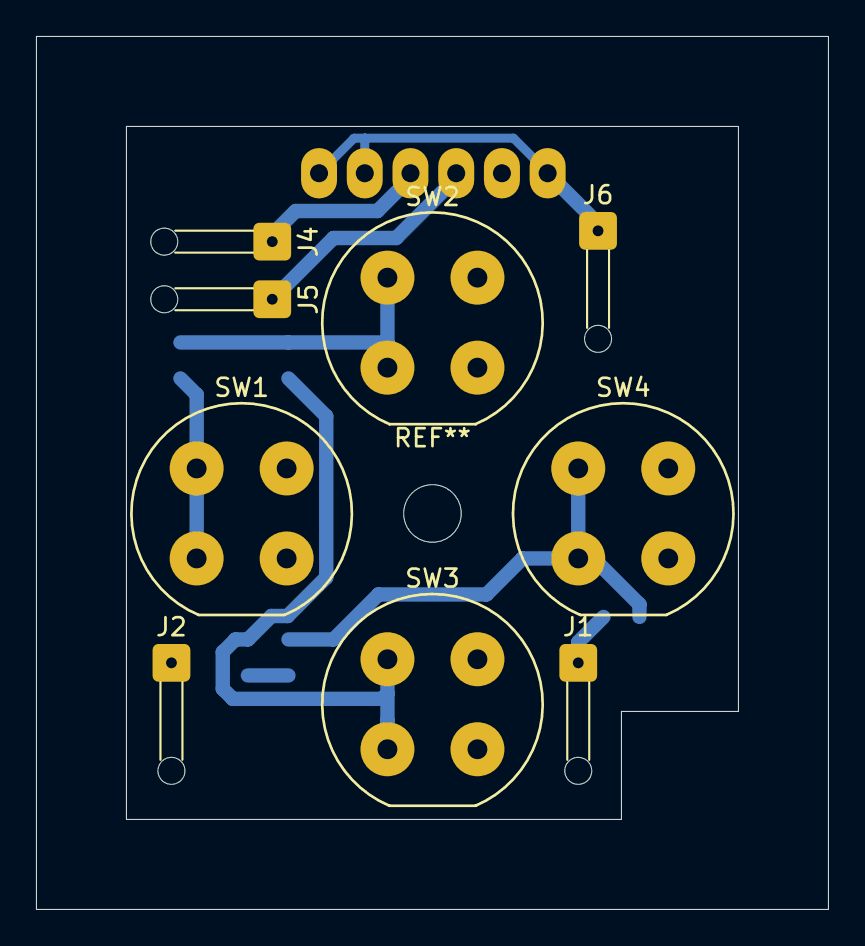
[picture p28: board keys.kicad_pcb from above]

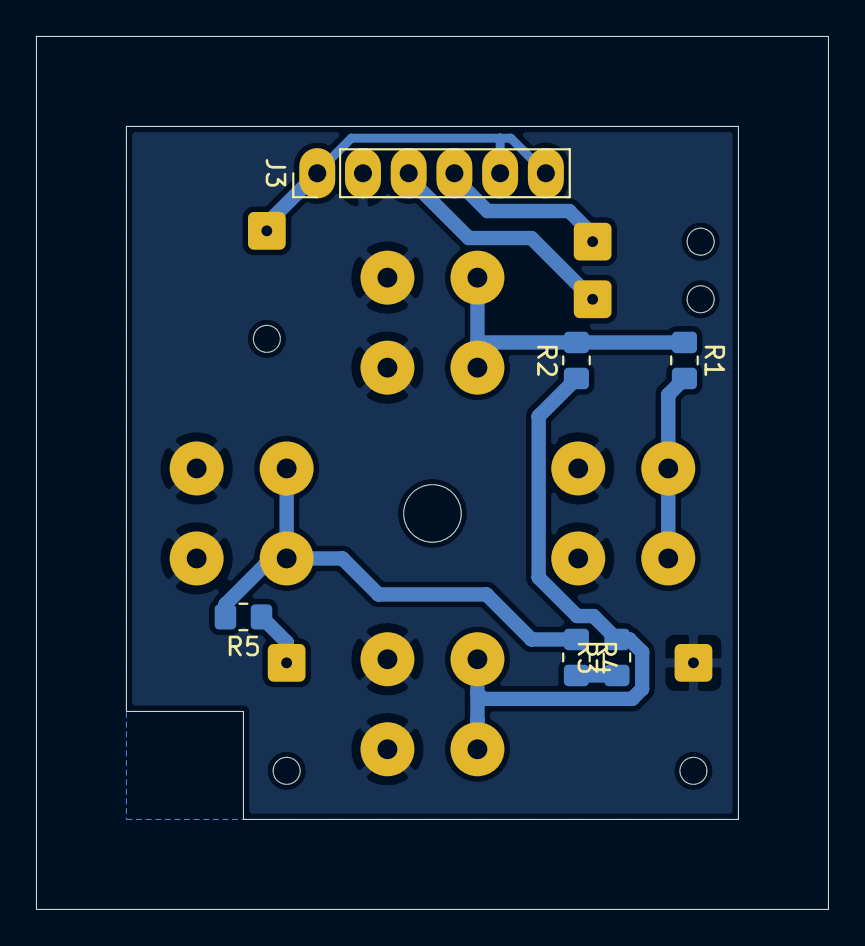
[picture p29: board keys.kicad_pcb from below]

Board: 2 copper layers, 44.0 x 48.5 mm, 15 parts (6 on the bottom side), 10 nets.
