mbouyer/weatherstation/hardware/coupleur-duallink/coupleur-duallink.kicad_pcb

## KiCad design hardware/coupleur-duallink/coupleur-duallink.kicad_pcb (2023-03-14)

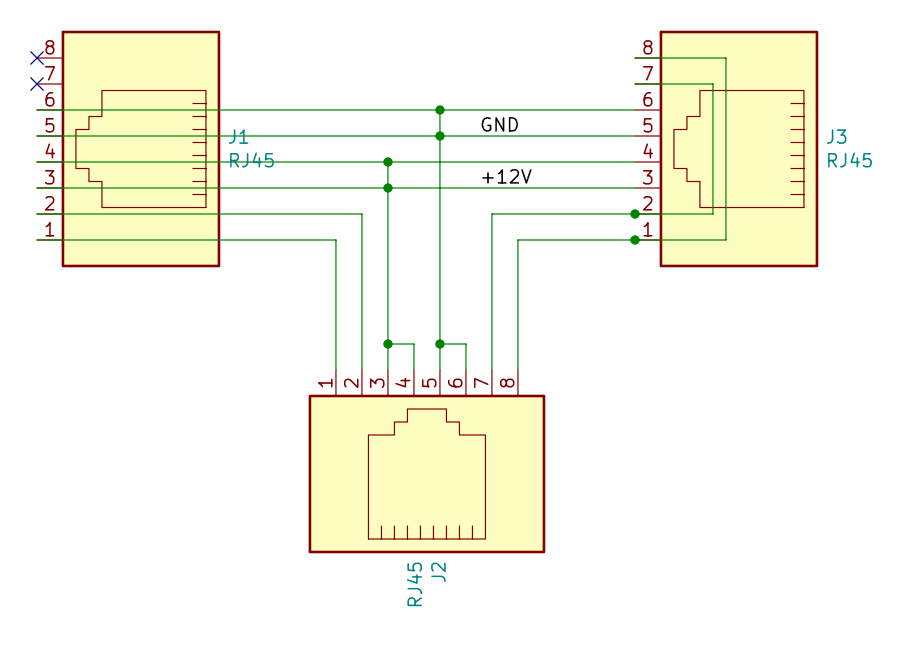
[picture p30: schematic coupleur-duallink.sch]

Parts:
J1, J2, J3: RJ45; RJ45_Amphenol_54602-x08_Horizontal

Connections:
/+12V: J1.3, J1.4, J2.3, J2.4, J3.3, J3.4
/GND: J1.5, J1.6, J2.5, J2.6, J3.5, J3.6
unnamed: J1.1, J2.1
unnamed: J1.2, J2.2
unnamed: J2.7, J3.2, J3.7
unnamed: J2.8, J3.1, J3.8

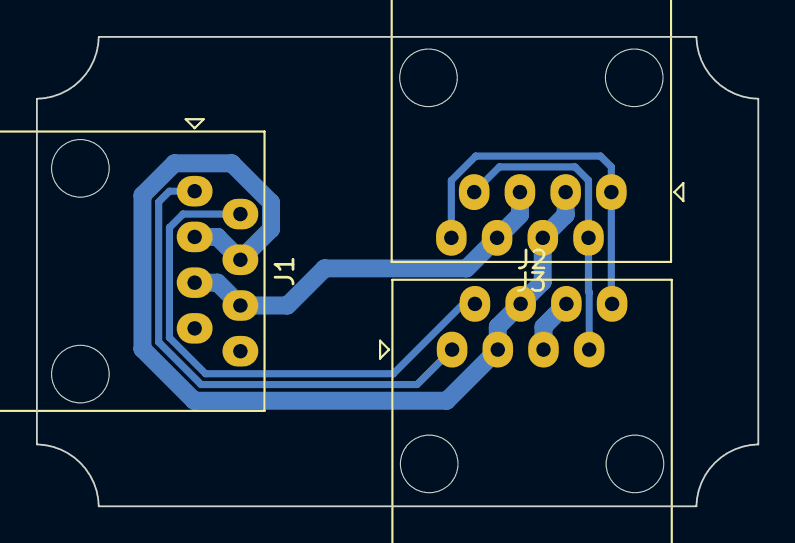
[picture p31: board coupleur-duallink.kicad_pcb from above]

Board: 2 copper layers, 40.1 x 26.1 mm, 3 parts (0 on the bottom side), 6 nets.
