mbouyer/weatherstation/hardware/capteur/capteur.kicad_pcb

## KiCad design hardware/capteur/capteur.kicad_pcb (2023-03-14)

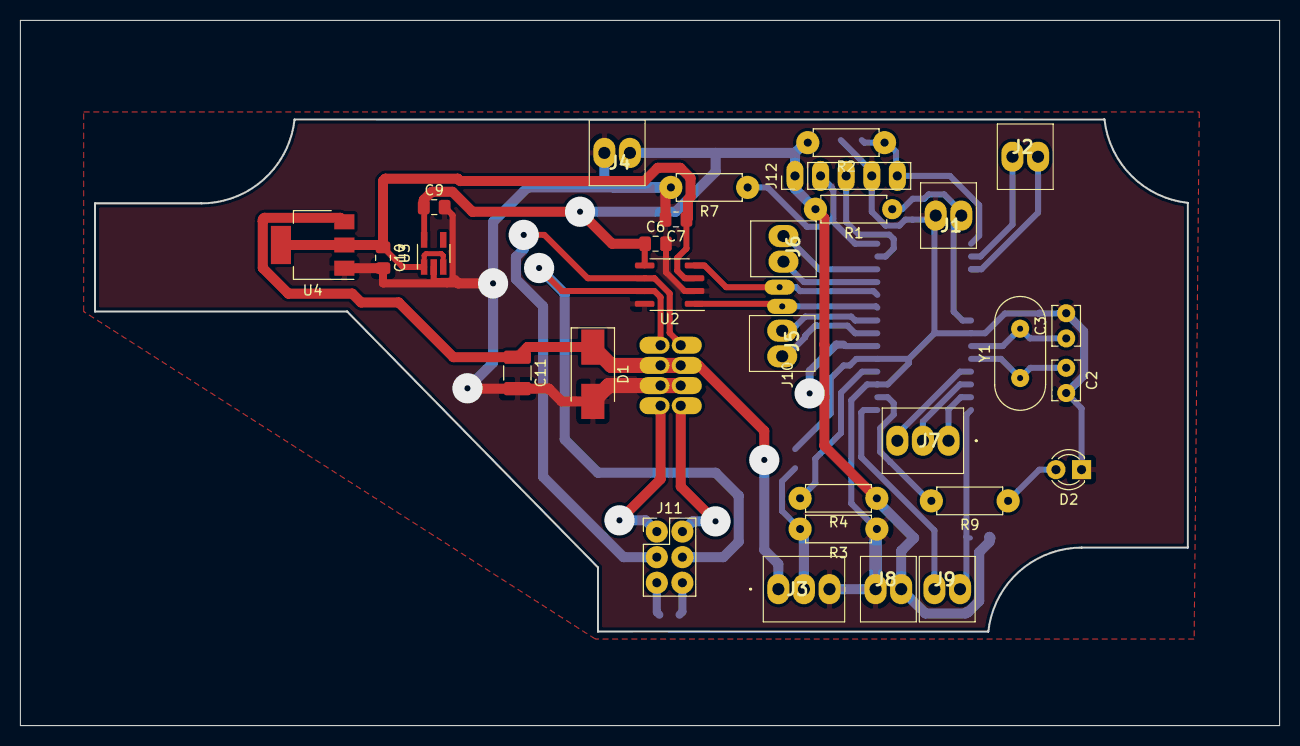
[picture p32: board capteur.kicad_pcb from above]

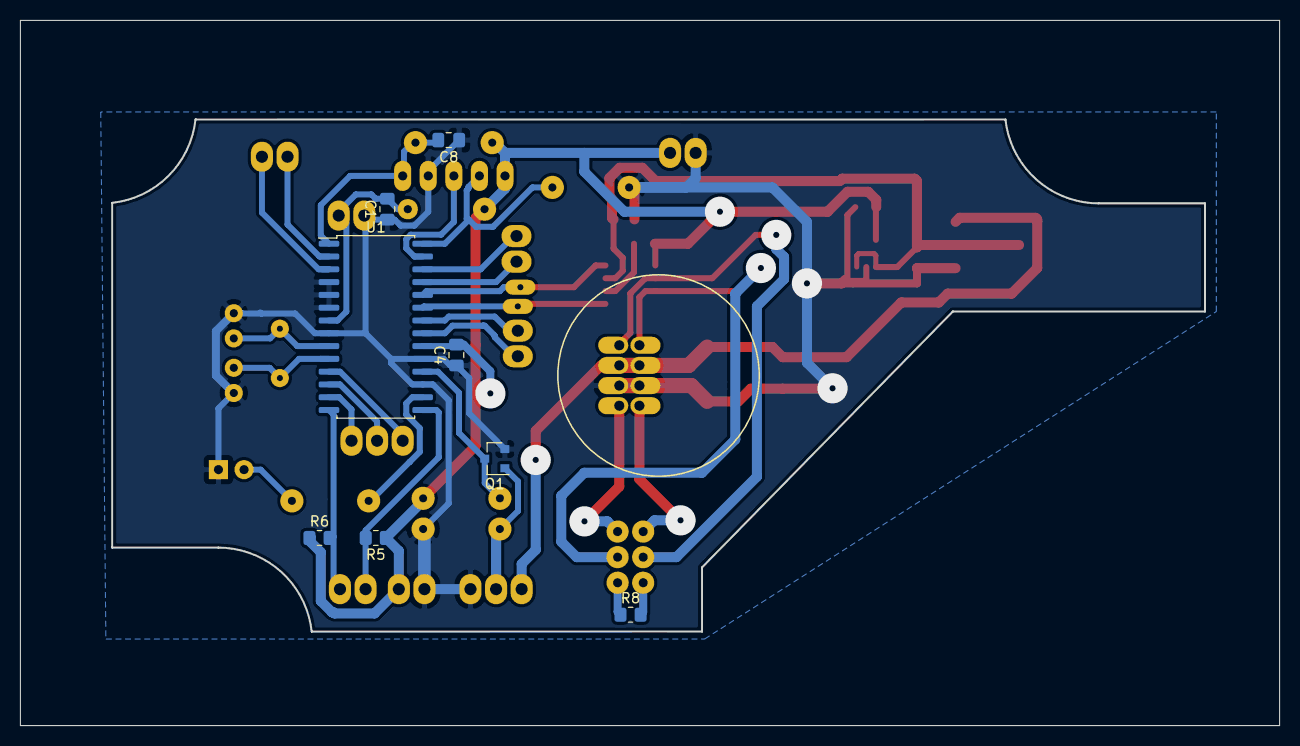
[picture p33: board capteur.kicad_pcb from below]

Board: 2 copper layers, 125.0 x 70.0 mm, 39 parts (8 on the bottom side), 33 nets.

Parts:
C1, C4, C6, C7, C8: 100nF; C_0805_2012Metric_Pad1.18x1.45mm_HandSolder
C2, C3: 22pF; C_Disc_D3.8mm_W2.6mm_P2.50mm
C9, C10: 1uF; C_0805_2012Metric_Pad1.18x1.45mm_HandSolder
C11: 10uF; C_1210_3225Metric_Pad1.33x2.70mm_HandSolder
D1: SMBJ16A; D_SMB_Handsoldering
D2: RED; LED_D3.0mm
J1: Pluvio; 282834-2_1
J2, J4, J5, J6: Conn_01x02_Male; 282834-2_1
J3: NMEA0183 (wind); 282834-3
J7: Conn_01x03_Male; 282834-3
J8: STH20 pwr; 282834-2_1
J9: STH20 i2c; 282834-2_1
J10: RJ45; multicomp_MP002453-swappedpins
J11: Term_sel; PinHeader_2x03_P2.54mm_Vertical
J12: Conn_01x05_Male; PinHeader_1x05_P2.54mm_Vertical
Q1: NMOS; SOT-23
R1, R2, R3, R7: 10K; R_Axial_DIN0207_L6.3mm_D2.5mm_P7.62mm_Horizontal
R4: 1K; R_Axial_DIN0207_L6.3mm_D2.5mm_P7.62mm_Horizontal
R5, R6: 4K7; R_0805_2012Metric_Pad1.20x1.40mm_HandSolder
R8: 100; R_0805_2012Metric_Pad1.20x1.40mm_HandSolder
R9: 330; R_Axial_DIN0207_L6.3mm_D2.5mm_P7.62mm_Horizontal
U1: PIC18F27Q84_ISS; SOIC-28W_7.5x17.9mm_P1.27mm
U2: TLE9250VSJXUMA1; SOIC-8_3.9x4.9mm_P1.27mm
U3: mic5504-3.3; SOT-23-5_HandSoldering
U4: LDL1117S50; SOT-223-3_TabPin2
Y1: 10Mhz; Crystal_HC18-U_Vertical

Connections:
+3V3: C4.2, C6.1, C9.1, J4.1, J8.2, J12.1, R1.2, R2.2, R4.1, R5.1, R6.1, U1.20, U2.5, U3.5
+5V: C7.1, C10.1, U2.3, U3.1, U3.3, U4.2
+12V: C11.1, D1.1, J3.1, J10.3, J10.4, U4.3
/CANH: J10.1, J11.4, U2.7
/CANL: J10.2, J11.3, U2.6
/CANRX: U1.24, U2.4
/CANTX: U1.23, U2.1
/MCLR: C8.2, J12.5, R2.1, U1.1
/PGC: J12.3, U1.27
/PGD: J12.2, R7.1, U1.28
/SCL: J9.2, R6.2, U1.14
/SDA: J9.1, R5.2, U1.15
GND: C1.1, C2.2, C3.2, C4.1, C6.2, C7.2, C8.1, C9.2, C10.2, C11.2, D1.2, D2.1, J1.2, J3.3, J4.2, J8.1, J10.5, J10.6, J12.4, Q1.2, R3.1, R7.2, U1.4, U1.5, U1.6, U1.8, U1.17, U1.19, U2.2, U2.8, U3.2, U4.1
unnamed: C1.2, J1.1, R1.1, U1.7
unnamed: C2.1, U1.10, Y1.1
unnamed: C3.1, U1.9, Y1.2
unnamed: D2.2, R9.1
unnamed: J2.1, U1.2
unnamed: J2.2, U1.3
unnamed: J3.2, Q1.1, R3.2
unnamed: J5.1, U1.22
unnamed: J5.2, U1.21
unnamed: J6.1, U1.26
unnamed: J6.2, U1.25
unnamed: J7.1, U1.13
unnamed: J7.2, U1.12
unnamed: J7.3, U1.11
unnamed: J10.7, J11.1
unnamed: J10.8, J11.2
unnamed: J11.5, R8.2
unnamed: J11.6, R8.1
unnamed: Q1.3, R4.2, U1.18
unnamed: R9.2, U1.16
