mbouyer/weatherstation/hardware/coupleur-5p/coupleur-5p.kicad_pcb

## KiCad design hardware/coupleur-5p/coupleur-5p.kicad_pcb (2022-05-02)

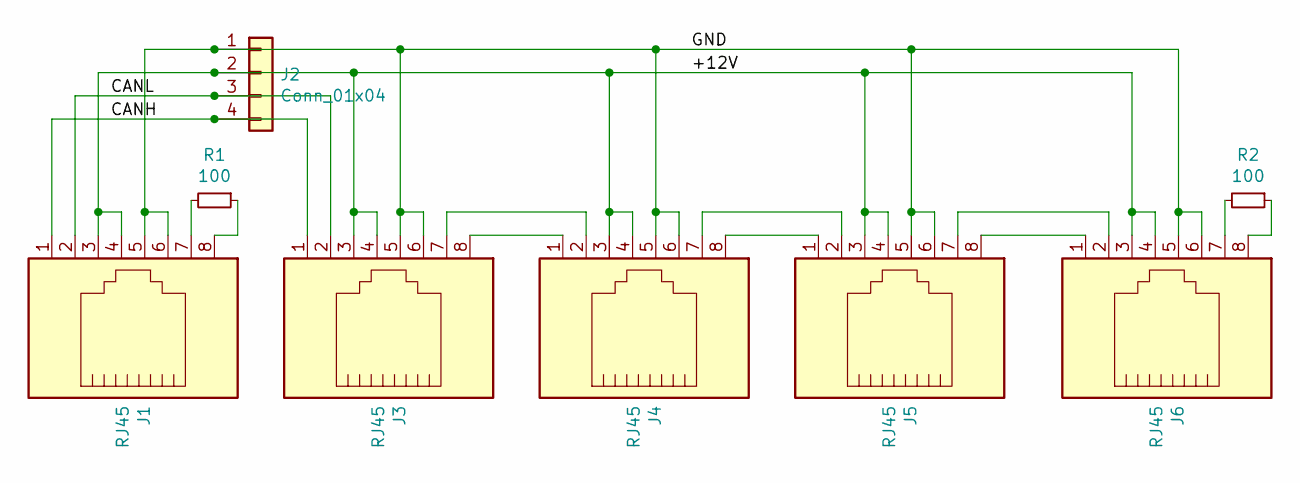
[picture p34: schematic coupleur-5p.sch]

Parts:
J1, J3, J4, J5, J6: RJ45; RJ45_Amphenol_54602-x08_Horizontal
J2: Conn_01x04; PinHeader_1x04_P2.54mm_Vertical
R1, R2: 100; R_0805_2012Metric_Pad1.20x1.40mm_HandSolder

Connections:
/+12V: J1.3, J1.4, J2.2, J3.3, J3.4, J4.3, J4.4, J5.3, J5.4, J6.3, J6.4
/CANH: J1.1, J2.4, J3.1
/CANL: J1.2, J2.3, J3.2
/GND: J1.5, J1.6, J2.1, J3.5, J3.6, J4.5, J4.6, J5.5, J5.6, J6.5, J6.6
unnamed: J1.7, R1.2
unnamed: J1.8, R1.1
unnamed: J3.7, J4.2
unnamed: J3.8, J4.1
unnamed: J4.7, J5.2
unnamed: J4.8, J5.1
unnamed: J5.7, J6.2
unnamed: J5.8, J6.1
unnamed: J6.7, R2.2
unnamed: J6.8, R2.1

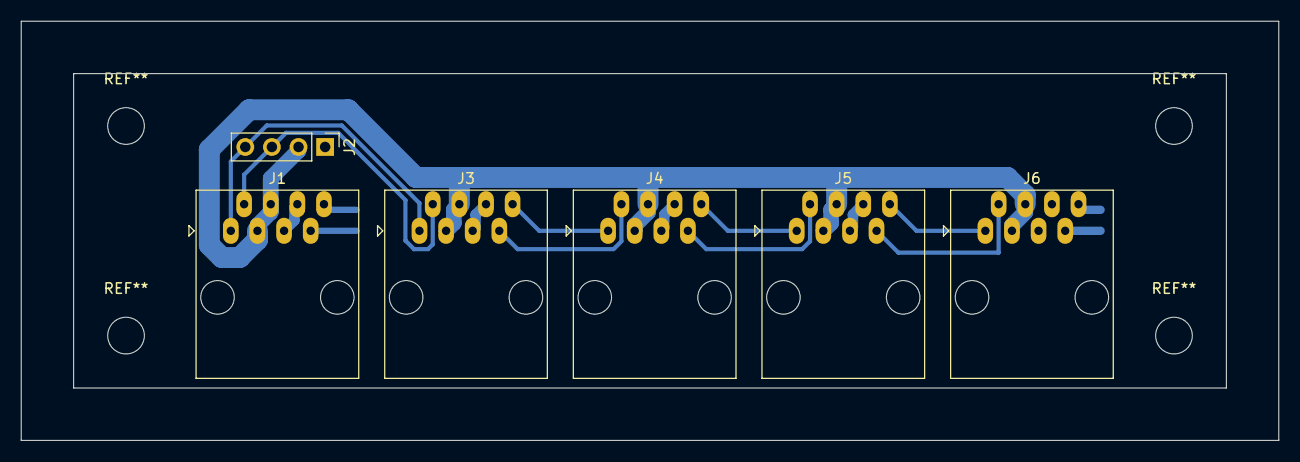
[picture p35: board coupleur-5p.kicad_pcb from above]

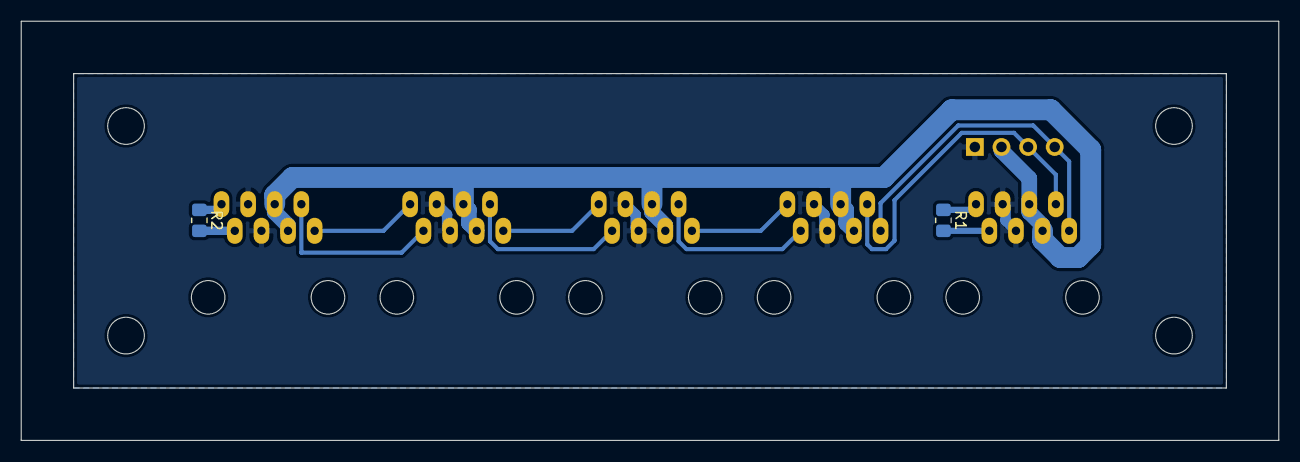
[picture p36: board coupleur-5p.kicad_pcb from below]

Board: 2 copper layers, 120.0 x 40.0 mm, 8 parts (2 on the bottom side), 14 nets.
