mbouyer/weatherstation/software/capteur/main.c

/* $Id: main.c,v 1.36 2019/03/12 19:24:19 bouyer Exp $ */
/*
 * Copyright (c) 2022 Manuel Bouyer
 *
 * All rights reserved.
 *
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
 * THIS SOFTWARE IS PROVIDED BY THE NETBSD FOUNDATION, INC. AND CONTRIBUTORS
 * ``AS IS'' AND ANY EXPRESS OR IMPLIED WARRANTIES, INCLUDING, BUT NOT LIMITED
 * TO, THE IMPLIED WARRANTIES OF MERCHANTABILITY AND FITNESS FOR A PARTICULAR
 * PURPOSE ARE DISCLAIMED.  IN NO EVENT SHALL THE FOUNDATION OR CONTRIBUTORS
 * BE LIABLE FOR ANY DIRECT, INDIRECT, INCIDENTAL, SPECIAL, EXEMPLARY, OR
 * CONSEQUENTIAL DAMAGES (INCLUDING, BUT NOT LIMITED TO, PROCUREMENT OF
 * SUBSTITUTE GOODS OR SERVICES; LOSS OF USE, DATA, OR PROFITS; OR BUSINESS
 * INTERRUPTION) HOWEVER CAUSED AND ON ANY THEORY OF LIABILITY, WHETHER IN
 * CONTRACT, STRICT LIABILITY, OR TORT (INCLUDING NEGLIGENCE OR OTHERWISE)
 * ARISING IN ANY WAY OUT OF THE USE OF THIS SOFTWARE, EVEN IF ADVISED OF THE
 * POSSIBILITY OF SUCH DAMAGE.
 */

#include <xc.h>
#include <stdio.h> 
#include <string.h> 
#include <stdlib.h> 
#include <nmea2000.h>
#include <nmea2000_pgn.h>
#include <raddeg.h>
#include "serial.h"
#include "i2c.h"

unsigned long devid, revid;

unsigned long nmea2000_user_id; 

static unsigned char sid;

static struct nmea2000_msg msg;
static unsigned char nmea2000_data[NMEA2000_DATA_LENGTH];

unsigned int timer0_read(void);
unsigned int timer1_read(void);
#pragma callee_saves timer0_read

#define TIMER0_5MS 48
#define TIMER0_1MS 10

#define LED LATCbits.LATC5

static unsigned char led_pattern;     

static char counter_10hz;
static char counter_1hz;
static unsigned char seconds;

static volatile union softintrs {
	struct softintrs_bits {
		char int_10hz : 1;	/* 0.1s timer */
		char anemo_rx : 1;	/* NMEA string ready */
	} bits;
	char byte;
} softintrs;

static enum i2c_status {
	IDLE,
	READ_TEMP,
	READ_HUM,
	SEND_TEMP,
	SEND_HUM,
	FAIL
} i2c_status;

#define STH20_ADDR	(0x40 << 1)
#define STH20_READT_H	0xe3
#define STH20_READH_H	0xe5
#define STH20_READT	0xf3
#define STH20_READH	0xf5
#define STH20_WRITER	0xe6
#define STH20_READR	0xe7
#define STH20_RESET	0xfe

int32_t temp; /* degK * 100 */
uint32_t hum; /* %RH * 1000 */
static char counter_sth20;
static uint16_t i2cval;

static uint16_t raincount;

#define ANEMO_BUFSIZE 128
static char anemo_rxbuf1[ANEMO_BUFSIZE];
static char anemo_rxbuf2[ANEMO_BUFSIZE];
static unsigned char anemo_rxbufi;
static unsigned char anemo_rxbufs;
static unsigned char anemo_rxbufs_ready;
static unsigned char anemo_rx_error;

#define ANEMO_DIR_OFFSET 1800 /* deg * 10 */

static uint16_t wind_speed; /* kn * 10 */
static uint16_t wind_angle; /* deg * 10 */
static unsigned char wind_ok;

static void
send_env_param(void)
{
	struct nmea2000_env_param *data = (void *)&nmea2000_data[0];

	PGN2ID(NMEA2000_ENV_PARAM, msg.id);
	msg.id.priority = NMEA2000_PRIORITY_INFO;
	msg.dlc = sizeof(struct nmea2000_env_param);
	msg.data = &nmea2000_data[0]; 
	data->sid  = sid; 
	data->tsource = ENV_TSOURCE_OUTSIDE;
	data->hsource = ENV_HSOURCE_OUTSIDE;
	data->temp = temp;
	data->hum = hum / 4;
	data->press = 0xffff;
	if (! nmea2000_send_single_frame(&msg))
		printf("send NMEA2000_ENV_PARAM failed\n");
}

static void
send_rain_counter(void)
{
	struct private_rain_counter *data = (void *)&nmea2000_data[0];

	PGN2ID(PRIVATE_RAIN_COUNTER, msg.id);
	msg.id.priority = NMEA2000_PRIORITY_INFO;
	msg.dlc = sizeof(struct private_rain_counter);
	msg.data = &nmea2000_data[0]; 
	data->sid  = sid;
	data->count = raincount;
	if (! nmea2000_send_single_frame(&msg))
		printf("send PRIVATE_RAIN_COUNTER failed\n");
}

static void
send_wind_data(void)
{
	struct nmea2000_wind_data *data = (void *)&nmea2000_data[0];

	PGN2ID(NMEA2000_WIND_DATA, msg.id);
	msg.id.priority = NMEA2000_PRIORITY_INFO;
	msg.dlc = sizeof(struct nmea2000_wind_data);
	msg.data = &nmea2000_data[0]; 
	data->sid  = sid; 
	if (wind_ok) {
		data->speed = (unsigned long)wind_speed * 1852UL / 360UL;
			/* (wind_speed / 10) * (1852 / 3600) * 100 */
		data->dir = deg2urad(wind_angle / 10);
	} else {
		data->speed = 0xffff;
		data->dir = 0xffff;
	}
	data->ref = WIND_REF_TRUE_N;
	if (! nmea2000_send_single_frame(&msg))
		printf("send NMEA2000_WIND_DATA failed\n");
}

void
user_handle_iso_request(unsigned long pgn)
{
	printf("ISO_REQUEST for %ld from %d\n", pgn, rid.saddr);
	switch(pgn) {
	case NMEA2000_ENV_PARAM:
		send_env_param();
		break;
	case NMEA2000_WIND_DATA:
		send_wind_data();
		break;
	case PRIVATE_RAIN_COUNTER:
		send_rain_counter();
		break;
	}
}

void
user_receive()
{
#if 0
	unsigned long pgn;

	pgn = ((unsigned long)rid.page << 16) | ((unsigned long)rid.iso_pg << 8);
	if (rid.iso_pg > 239)
		pgn |= rid.daddr;

	switch(pgn) {
	case PRIVATE_COMMAND_STATUS:
	{
		struct private_command_status *command_status = (void *)rdata;
		last_command_data = timer0_read();
		nmea2000_command_address = rid.saddr;
		command_received_heading = command_status->heading;
		received_auto_mode = command_status->auto_mode;
		received_param_slot = command_status->params_slot;
		break;
	}
	}
#endif
}

void
putch(char c)
{
        if (PORTBbits.RB7) {
		usart_putchar(c);
	}
#ifdef N2K_PRINTF
        nmea2000_putchar(c);
#endif
}

static void
sth20_read(void) {
	switch(i2c_status) {
	case READ_TEMP:
		if (i2c_readvalue(STH20_ADDR, &i2cval) != 0) {
			i2cval &= 0xfffc;
			temp = (int32_t)i2cval * 17572 / 65536
			    + 22630 /* - 4685 + 27315 */;
			printf("STH20 temp 0x%x %ld\n", i2cval, temp);
		} else {
			printf("READ_TEMP failed\n");
		}
		i2c_status = SEND_HUM;
		break;
	case READ_HUM:
		if (i2c_readvalue(STH20_ADDR, &i2cval) != 0) {
			float tmp = (i2cval & 0xfffc);
			tmp = tmp * 125000.0 / 65536.0 - 6000.0;
			if (tmp < 0)
				tmp = 0;
			if (tmp > 100000)
				tmp = 100000;
			hum = tmp;
			printf("STH20 hum 0x%x %lu\n", i2cval, hum);
		} else {
			printf("READ_HUM failed\n");
		}
		i2c_status = SEND_TEMP;
		send_env_param();
		SIDINC(sid);
		break;
	}
}

static void
sth20_send(void)
{
	switch(i2c_status) {
	case SEND_TEMP:
		if (counter_sth20 == 0) {
			if (i2c_writecmd(STH20_ADDR, STH20_READT) != 0) {
				i2c_status = READ_TEMP;
				counter_sth20 = 10; /* one measure every 10s */
			} else {
				printf("STH20_READT failed\n");
			}
		}
		break;
	case SEND_HUM:
		if (i2c_writecmd(STH20_ADDR, STH20_READH) != 0) {
			i2c_status = READ_HUM;
		} else {
			printf("STH20_READH failed\n");
		}
		break;
	}
	if (counter_sth20 != 0) 
		counter_sth20--;

}

static void
parse_anemo_rx(void)
{
	static char *rxbuf, *crxbuf;
	static unsigned char i;
	unsigned char dot;
	unsigned char csum, rcsum;

	i = 0;
	if (anemo_rxbufs_ready == 0) {
		rxbuf = anemo_rxbuf1;
		printf("anemo1 %s\n", rxbuf);
	} else {
		rxbuf = anemo_rxbuf2;
		printf("anemo2 %s\n", rxbuf);
	}
	if (*rxbuf != '$')
		return;
	rxbuf++; i++;
	crxbuf = rxbuf;
	csum = 0;
	while (*crxbuf != '*') {
		if (*crxbuf == 0 || i >= (ANEMO_BUFSIZE - 4))
			return;
		csum ^= *crxbuf;
		crxbuf++;
		i++;
	}
	i++; crxbuf++; /* skip '*' */
	rcsum = 0;
	if (*crxbuf >= '0' && *crxbuf <= '9')
		rcsum += *crxbuf - '0';
	else if (*crxbuf >= 'A' && *crxbuf <= 'F')
		rcsum += *crxbuf + 0x0A - 'A';
	else
		return;
	i++; crxbuf++;
	rcsum = rcsum << 4;
	if (*crxbuf >= '0' && *crxbuf <= '9')
		rcsum += *crxbuf - '0';
	else if (*crxbuf >= 'A' && *crxbuf <= 'F')
		rcsum += *crxbuf + 0x0A - 'A';
	else
		return;

	printf("rcsum 0x%x csum 0x%x\n", rcsum, csum);
	if (rcsum != csum)
		return;

	for (i = 1; i < 10 ; i++, rxbuf++) {
		/* we should have the NMEA ID 'MWV' in the first few chars */
		if (*rxbuf == 0)
			return;
		if (rxbuf[0] == 'M' && rxbuf[1] == 'W' && rxbuf[2] == 'V') {
			rxbuf += 3;
			i += 3;
			break;
		}
		rxbuf++; i++;
	}
	printf("found MWV\n");
	if (*rxbuf != ',')
		return;
	rxbuf++; i++;
	dot = 0;
	wind_angle = 0;
	wind_ok = 0;
	while(*rxbuf != ',') {
		if (*rxbuf == 0 || i >= ANEMO_BUFSIZE)
			return;

		if (*rxbuf == '.') {
			rxbuf++; i++;
			dot++;
			continue;
		}
		if (*rxbuf < '0' || *rxbuf > '9')
			return;
		wind_angle = wind_angle * 10;
		wind_angle += *rxbuf - '0';
		rxbuf++; i++;
	}
	if (dot == 0)
		wind_angle = wind_angle * 10;
	wind_angle = wind_angle + ANEMO_DIR_OFFSET;
	if (wind_angle > 3600)
		wind_angle = wind_angle - 3600;
	printf("wangle %d\n", wind_angle);

	rxbuf++; i++; /* skip , */
	rxbuf++; i++; /* skip R/T */
	rxbuf++; i++; /* skip , */

	wind_speed = 0;
	dot = 0;
	while(*rxbuf != ',') {
		if (*rxbuf == 0 || i >= ANEMO_BUFSIZE)
			return;

		if (*rxbuf == '.') {
			rxbuf++; i++;
			dot++;
			continue;
		}
		if (*rxbuf < '0' || *rxbuf > '9')
			return;
		wind_speed = wind_speed * 10;
		wind_speed += *rxbuf - '0';
		rxbuf++; i++;
	}
	if (dot == 0)
		wind_speed = wind_speed * 10;
	printf("wspeed %d\n", wind_speed);

	rxbuf++; i++; /* skip , */
	switch(*rxbuf) {
		case 'N': /* knots */
			break;
		case 'M': /* m/s */
			wind_speed =
			    (unsigned long)wind_speed * 3600UL / 1852UL; 
			break;
		case 'K': /* km/h */
			wind_speed =
			    (unsigned long)wind_speed * 1000UL / 1852UL; 
			break;
		default:
			return;
	}
	rxbuf++; i++; /* skip N/M/K */
	rxbuf++; i++; /* skip , */
	if (*rxbuf == 'A')
		wind_ok = 1;
	printf("wok %d\n", wind_ok);
}

int
main(void)
{
	char c;
	static unsigned int poll_count;

	sid = 0;

	softintrs.byte = 0;
	counter_10hz = 25;
	counter_1hz = 10;
	seconds = 0;
	i2c_status = IDLE;

	anemo_rxbufi = 0;
	anemo_rxbufs = 0;
	anemo_rx_error = 0;
	wind_ok = 0;

        /* read devid and user IDs */ 
	TBLPTR = 0x200000;
	asm("tblrd*+;");
	asm("movff TABLAT, _nmea2000_user_id;");
	asm("tblrd*+;");
	asm("movff TABLAT, _nmea2000_user_id + 1;");
	TBLPTR = 0x3ffffc;
	asm("tblrd*+;");
	asm("movff TABLAT, _revid;"); 
	asm("tblrd*+;");
	asm("movff TABLAT, _revid + 1;");
	asm("tblrd*+;");
	asm("movff TABLAT, _devid;"); 
	asm("tblrd*+;");
	asm("movff TABLAT, _devid + 1;");

	/* disable unused modules */  
	PMD0 = 0x7a; /* keep clock and IOC */
	PMD1 = 0xfc; /* keep timer0/1 */
	PMD2 = 0x02; /* keep can module, TU16A */
	PMD3 = 0xff;
	PMD4 = 0xff;
	PMD5 = 0xff;
	PMD6 = 0xe6; /* keep UART2, UART1 and I2C */
	PMD7 = 0xff;
	PMD8 = 0xff;

	ANSELC = ANSELB = ANSELA = 0; 
	LED = 0;
	TRISCbits.TRISC5 = 0;
	LED = 1;

        /* CANRX on RB3 */
	CANRXPPS = 0x0B;
	/* CANTX on RB2 */
	LATBbits.LATB2 = 1; /* output value when idle */
	TRISBbits.TRISB2 = 0;
	RB2PPS = 0x46;

	/* configure watchdog timer for 2s */
	WDTCON0 = 0x16;
	WDTCON1 = 0x07;

	/* configure sleep mode: PRI_IDLE */
	CPUDOZE = 0x80;

	/* everything is low priority by default */
	IPR1 = 0;
	IPR2 = 0;
	IPR3 = 0;
	IPR4 = 0;
	IPR5 = 0;
	IPR6 = 0;
	IPR7 = 0;
	IPR8 = 0;
	IPR9 = 0;
	IPR10 = 0;
	IPR11 = 0;
	IPR12 = 0;
	IPR13 = 0;
	IPR14 = 0;
	IPR15 = 0;
	INTCON0 = 0;
	INTCON1 = 0;
	INTCON0bits.IPEN=1; /* enable interrupt priority */

	USART_INIT(0)

	/* configure timer0 as free-running counter at 9.765625Khz * 4 */
	T0CON0 = 0x0;
	T0CON0bits.MD16 = 1; /* 16 bits */
	T0CON1 = 0x48; /* 01001000 Fosc/4, sync, 1/256 prescale */      
	PIR3bits.TMR0IF = 0;
	PIE3bits.TMR0IE = 0; /* no interrupt */
	T0CON0bits.T0EN = 1;

	/* configure UTMR for 10Hz interrupt */
	TU16ACON0 = 0x04; /* period match IE */
	TU16ACON1 = 0x00;
	TU16AHLT = 0x00; /* can't use hardware reset because of HW bug */
	TU16APS = 249; /* prescaler = 250 -> 40000 Hz */
	TU16APRH = (4000 >> 8) & 0xff;
	TU16APRL = 4000 & 0xff;       
	TU16ACLK = 0x2; /* Fosc */    
	TUCHAIN = 0;
	TU16ACON0bits.ON = 1;
	TU16ACON1bits.CLR = 1;
	IPR0bits.TU16AIP = 1; /* high priority interrupt */
	PIE0bits.TU16AIE = 1;

	I2C_INIT;

	/* configure UART2 (anemo) for 4800Bps at 10Mhz */
	U2RXPPS = 0x17; /* RC7 */     
	U2BRGL = 129;
	U2BRGH = 0;
	U2CON0 = 0x10; /* RXEN */     
	U2CON2 = 0x80; /* run during overflow */
	U2CON1 = 0; /* off for now */ 
	U2ERRIE = 0;
	IPR8bits.U2RXIP = 0;

	INTCON0bits.GIEH=1;  /* enable high-priority interrupts */
	INTCON0bits.GIEL=1; /* enable low-priority interrrupts */

        printf("hello user_id 0x%lx devid 0x%x revid 0x%x\n", nmea2000_user_id,
	    devid, revid);

	nmea2000_init();
	poll_count = timer0_read();

	/* enable watch dog timer */
	WDTCON0bits.SEN = 1;

	printf("\nready");
	while (nmea2000_status != NMEA2000_S_OK) {
		nmea2000_poll(5);
		while ((timer0_read() - poll_count) < TIMER0_5MS) {
			nmea2000_receive();
		}
		poll_count = timer0_read();
		CLRWDT();
	}

	printf(", addr %d, id %ld\n", nmea2000_addr, nmea2000_user_id);

	if (i2c_writecmd(STH20_ADDR, STH20_READR) == 0) {
		printf("STH20_READR fail\n");
		i2c_status = FAIL;
	} else {
		i2c_readvalue(STH20_ADDR, &i2cval);
		printf("sth20 reg 0x%x\n", i2cval);
		i2c_status = SEND_TEMP;
	}
	counter_sth20 = 0;

	printf("RA5 0x%x\n", RA5PPS);
	TRISAbits.TRISA5 = 1;
	/* setup timer1 */
	T1CKIPPS = 0x5; /* T1 clock on PORTA5 */
	TMR1H = 0;
	TMR1L = 0;
	T1CON = 0x03; /* async, RD16 */
	T1GCON = 0;
	T1CLK = 0; /* clock on T1CKIPPS */
	T1CONbits.TMR1ON = 1;

	/* enable anemo RX */
	U2CON1 = 0x80; /* on */       
	PIE8bits.U2RXIE = 1;

	led_pattern = 0x55; /* 4 blinks at startup */

again:
	printf("hello user_id 0x%lx devid 0x%lx\n", nmea2000_user_id, devid);
	while (1) {
		CLRWDT();
		if (C1INTLbits.RXIF) {
			nmea2000_receive();
		}

		if (nmea2000_status != NMEA2000_S_OK) {
			uint16_t ticks, tmrv;
			tmrv = timer0_read();
			ticks = tmrv - poll_count;
			if (ticks > TIMER0_5MS) {
				poll_count = tmrv;
				nmea2000_poll(ticks / TIMER0_1MS);
			}
			if (nmea2000_status == NMEA2000_S_OK) {
				printf("new addr %d\n", nmea2000_addr);
			}
		};

		if (softintrs.bits.int_10hz) {
			softintrs.bits.int_10hz = 0;
			sth20_read();
			counter_1hz--;
			if (counter_1hz == 0) {
				counter_1hz = 10;
				seconds++;
				if (nmea2000_status != NMEA2000_S_OK &&
				    led_pattern == 0) {
					led_pattern = 0xf; /* one long blink */
				}
				if (canbus_mute) {
					led_pattern = 0x1; /* 1 short blink */ 
				} else if (wind_ok == 0) {
					led_pattern = 0x5; /* 2 short blink */ 
				}     
				wind_ok = 0;

				sth20_send();

				if (seconds == 10) {
					seconds = 0;
					raincount = timer1_read();
					printf("rain %d\n", raincount);
					send_rain_counter();
					SIDINC(sid);
					/* in normal state, one short
					 * blink every 10s
					 */ 
					if (led_pattern == 0)
						led_pattern = 1;
				}
			}
			LED = (led_pattern & 0x1);
			led_pattern = led_pattern >> 1;
			if (nmea2000_status == NMEA2000_S_OK) {
				uint16_t ticks, tmrv;  

				tmrv = timer0_read();
				ticks = tmrv - poll_count;
				if (ticks > TIMER0_5MS) {
					poll_count = tmrv;
					nmea2000_poll(ticks / TIMER0_1MS);
				 }
				 if (nmea2000_status != NMEA2000_S_OK) { 
					 printf("lost CAN bus %d\n", ticks);
														 }     
													 }
		}
		if (softintrs.bits.anemo_rx) {
			parse_anemo_rx();
			softintrs.bits.anemo_rx = 0;
			if (wind_ok) {
				send_wind_data();
				SIDINC(sid);
			}
		}

		if (PIR4bits.U1RXIF && (U1RXB == 'r'))
			break;

		if (nmea2000_status == NMEA2000_S_OK) {
			SLEEP();
		}
	}
	while ((c = getchar()) != 'r') {
		printf("resumed\n");
		goto again;
	}
end:
	WDTCON0bits.SEN = 0;
	printf("returning\n");
	while (!PIR4bits.U1TXIF)      
		; /* wait for transmit to complete */
	INTCON0bits.GIEH=0;
	INTCON0bits.GIEL=0;
	RESET();
	return 0;
}

unsigned int
timer0_read()
{
	unsigned int value;

	/* return TMR0L | (TMR0H << 8), reading TMR0L first */
	di();
	asm("movff TMR0L, timer0_read@value");
	asm("movff TMR0H, timer0_read@value+1");
	ei();
	return value;
}

unsigned int
timer1_read()
{
	unsigned int value;

	/* return TMR1L | (TMR1H << 8), reading TMR1L first */
	di();
	asm("movff TMR1L, timer0_read@value");
	asm("movff TMR1H, timer0_read@value+1");
	ei();
	return value;
}

void
delay_ms(unsigned char delay)
{
	unsigned int date = timer0_read();
	unsigned int diff;
	do {
		diff = timer0_read() - date;
	} while (diff < delay * TIMER0_1MS);
}

void __interrupt(__irq(TU16A), __high_priority, base(IVECT_BASE))       
irqh_tu16a(void)
{
	TU16ACON1bits.CLR = 1;
	TU16ACON1bits.PRIF = 0;       
	softintrs.bits.int_10hz = 1;  
}

void __interrupt(__irq(U2RX), __low_priority, base(IVECT_BASE))
irql_uart2(void)
{
	char c;
	while (PIE8bits.U2RXIE && PIR8bits.U2RXIF) {
		//if (U2ERRIRbits.FERIF) {
		// 	anemo_rx_error++;
		//}
		c = U2RXB;
		if (c == 0x0a) {
			; /* ignore */
		} else if (c == 0x0d) {
			anemo_rxbufs_ready = anemo_rxbufs;
			if (anemo_rxbufs == 0) {
				anemo_rxbuf1[anemo_rxbufi] = 0;
				anemo_rxbufs = 1;
			} else {
				anemo_rxbuf2[anemo_rxbufi] = 0;
				anemo_rxbufs = 0;
			}
			anemo_rxbufi = 0;
			if (anemo_rx_error)
				anemo_rx_error = 0;
			else 
				softintrs.bits.anemo_rx = 1;
		} else {
			if (anemo_rxbufi < (ANEMO_BUFSIZE - 1)) {
				if (anemo_rxbufs == 0) {
					anemo_rxbuf1[anemo_rxbufi] = c;
				} else {
					anemo_rxbuf2[anemo_rxbufi] = c;
				}
				anemo_rxbufi++;
			} else {
				anemo_rx_error++;
			}
		}
		if (U2ERRIRbits.RXFOIF) {
			U2ERRIRbits.RXFOIF = 0;
			anemo_rx_error++;
		}
	}
}
