mbouyer/weatherstation/(commit log)

2021-04-18 Image de l'afficheur Vetus
2021-04-18 Commit initial du projet
    [1555CGY-pcb.dxf, RX2007_S-5-board.dxf, RX2007_S-5.dxf, capteur.kicad_pcb, capteur.sch, centrale-2021-03-11-19-09-22.sch, centrale.kicad_pcb, centrale.sch]
2021-04-23 Modifications mineures pour fabrication
    [capteur.kicad_pcb, centrale.kicad_pcb, power.kicad_pcb, power.sch, vetus.kicad_pcb, vetus.sch]
2021-04-23 L'empreinte utilisée pour le connecteur RJ45 MP002453 est inversée; modification du nom utilisé pour le montrer.
    [capteur.kicad_pcb, capteur.sch]
2021-04-24 Configuration kernel et device tree pour netbsd-9.
2021-04-26 Disable more devices. Especially AHCI which shares a pin with LCD_RSTB
2021-04-26 firmware de base pour les pic18, avec support CAN/N2K. Ils obtiennent une adresse et répondent au message ISO_ADDRESS_CLAIM
2021-04-26 Marque NMEA2000_USER_DEVICE_CLASS explicitement comme unsigned, pour éviter un overflow dans la lib N2K
2021-04-26 Rends la convertion .hex -> .bin optionelle, la programmation a travers le bus CAN utilise le .hex
2021-04-26 Surpression de NMEA2000_USER_NAME, non-utilisé
2021-04-26 Initialise I2C et le DAC MCP4706.
2021-04-27 define CAN_PORTB (après MAJ de pic18_n2k)
2021-04-27 Configure les LEDs et BATT_ON
2021-04-28 Add i2c infrastructure and read the INA226 manuf/die code.
2021-04-28 Query and send periodic battery status
2021-04-28 Setup and use the ADCC to query the input voltage
2021-04-30 Supression de l'utilisation de INA_ALERT: nous n'utiliseront pas les alertes et le bit CONVERTION_READY n'est pas utilisable en mode continous. is not set in continous mode.
2021-04-30 Mesure la NTC (température de la batterie)
2021-04-30 Correction de l'arrondi dans NMEA2000_DC_STATUS
    [main.c]
2021-04-30 Implementation du chargeur. Le calcul de l'état de charge est basique.
2021-04-30 Corrige débordement dans le calcul du SoC
    [main.c]
2021-05-01 Transmet les trames NMEA2000_ENV_PARAM
2021-05-01 Nome les signaux SCL et SDA (pour repérage facile)
    [capteur.kicad_pcb, capteur.sch]
2021-05-01 Configure timer1 pour compter les impulsions du pluviomètre
2021-05-02 utilise des #define pour les constantes batteries. Pas de changement fonctionnel
2021-05-03 Premier jet du support batterie/PCB pour l'alimentation. Prévu pour un boitier DN16E
    [base.dxf, pcb.dxf, support.scad]
2021-05-03 Prévois 1mm de jeu en bas du PCB. Ajustements pour l'utilisation d'inserts M3
    [pcb.dxf, support.scad]
2021-05-03 Fichier dupliqué
    [1555CGY-pcb.dxf]
2021-05-03 Fichier dupliqués dans CAD/
    [support-pluvio.dxf, support-pluvio.scad]
2021-05-03 Découpe pour les connecteurs dans le boitier.
    [1555CGY-couvercle.dxf]
2021-05-04 Ajout de butées pour maintenir la batterie centrée.
    [base.dxf, support.scad]
2021-05-04 trace les butées sur une couche différente
    [pcb.dxf]
2021-05-04 Réhausse les butées.
    [support.scad]
2021-05-05 Ajout référence NTC
    [power.kicad_pcb, power.sch]
2021-05-05 Correction des valeurs d'après la datasheet de la thermistance
2021-05-05 Configure le port série pour la réception NMEA
2021-05-05 Envoi de PRIVATE_RAIN_COUNTER, et diverses petite corrections
    [main.c]
2021-05-06 Autotest de l'affichage au boot, timeout sur les données de vent
2021-05-06 créé une fonction pour la gestion des LEDs. Implémente la réception des trames WIND_DATA
2021-05-07 Modifs pour l'usinage
    [1555CGY-couvercle.dxf]
2021-05-08 Ajustement de la convertion vent/DAC
2021-05-23 Debut d'un driver CAN/N2k pour weewx. Gère NMEA2000_ENV_PARAM et PRIVATE_RAIN_COUNTER pour le moment.
2021-05-24 Un service pour weewx, qui ajoutes les données issues de la commande envstat pour la télémetrie
2021-05-26 Abaisse le taux de donnnées vent à max un par seconde, en calculant et envoyant la moyenne sur l'intervalle. Un taux de messages trop élevé est trop gourmand en CPU avec MQTT
2021-05-29 renvoie une erreur en cas de timeout dans I2C_WAIT au lieu de faire un reset. Rend le capteur plus robuste en cas de défaillance de la sonde SHT20
    [i2c.c, main.c]
2021-05-30 Ajoute la correction du décalage dans la direction du vent
    [main.c]
2021-06-03 La doc dit: mettre à zero les deux bits de poids faible avant de calculer les valeurs température et humidité.
2021-06-03 Limite les valeurs d'humidité à [0-100]
2021-10-17 Prepare for v2: fix display connector wiring, remplace the CAN transeiver with a pin-compatible one which is not out of stock, enlarge a bit the CPU cooling window.
    [centrale.kicad_pcb, centrale.sch]
2021-10-17 Use a MC24356 connector for the CPU power supply. Other minor cleanups
    [centrale.kicad_pcb, centrale.sch]
2021-10-17 Add a simple command line program to dump the power battery status
2021-10-18 Add a coupler using both CAN link (for rescue of broken connector)
    [coupleur-duallink.kicad_pcb, coupleur-duallink.sch]
2021-10-20 Change DC/DC output capacitors to 1210 size. Theses are better at 5V bias, hoping this will decrease the noise of the inductor.
    [centrale.kicad_pcb, centrale.sch]
2022-01-12 More clearance
    [centrale.kicad_pcb]
2022-03-15 capteur: Update schematic for v2 switch to pic18f27q84, change CAN transeiver reference (it's pin-compatible), switch regulators to LDL1117S50/mic5504-3.3. Also use a RJ45 connector with the right pi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
    [capteur.sch]
2022-03-15 capteur v2: shrink PCB by 0.5mm on all edges, so that it fits better in enclosure. remove mounting hole, we don't use them.
    [1555CGY-pcb.dxf, capteur.kicad_pcb]
2022-03-15 capteur v2: add a LED for debug purposes.
    [capteur.sch]
2022-03-16 On second though, keep the swappedpin connector - we already have the cable :)
    [capteur.sch]
2022-03-16 Swap crystal pins to match PCB
    [capteur.sch]
2022-03-16 Connect pic18's unused pins to GND
    [capteur.sch]
2022-03-16 Increase isolation to 0,3mm reroute PCB after schematic changes.
    [capteur.kicad_pcb]
2022-03-24 Enlarge some through-hole pad, for easier soldering
    [capteur.kicad_pcb]
2022-03-27 Convert back more pads to via. Move vias outside of component footprint
    [capteur.kicad_pcb]
2022-03-28 Add a 5-connectors coupler, for a star-like wiring.
    [coupleur-5p.kicad_pcb, coupleur-5p.sch]
2022-03-30 Add a small PCB for 4 buttons and a BME280 module.
    [keys.kicad_pcb, keys.sch]
2022-03-30 Begin designing an enclosure
    [PCB.dxf, display.dxf]
2022-03-30 Adjust some dimensions Add some informations
    [PCB.dxf, display.dxf]
2022-03-30 First version of PCB support.
    [PCB.dxf, pcb.scad]
2022-03-31 Generate gerber files for new capteur version
    [capteur.kicad_pcb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]
2022-03-31 Longer holes for PCB screws
    [pcb.scad]
2022-03-31 WIP on display emclosure
    [display.dxf, display.scad]
2022-03-31 more space for clips
    [keys.kicad_pcb]
2022-03-31 Add PCB supports
    [display.dxf, display.scad]
2022-03-31 Add supports for the LCD
    [display.dxf, display.scad]
2022-03-31 - Round the harms - mirror the whole thing, as the Z axis ix reversed
    [display.scad]
2022-03-31 Adjust holes for our M3 inserts
    [pcb.scad]
2022-03-31 Add hole for screws on arms
    [display.scad]
2022-04-01 Add 5mm margin around PCBs
    [coupleur-5p.kicad_pcb, coupleur.kicad_pcb, keys.kicad_pcb]
2022-04-01 Fix edges; only 2 layers
    [coupleur.kicad_pcb]
2022-04-01 Only 2 layers
    [coupleur-5p.kicad_pcb]
2022-04-01 Add some fabrication files
    [coupleur-5p.kicad_pcb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]
2022-04-02 better shape for clips
    [display.scad]
2022-04-05 clips are not strong enough, so remplace with a screw for PCB
    [display.dxf, display.scad, keys.kicad_pcb]
2022-04-06 Regen fab files
    [keys-B_Cu.gbr, keys.drl]
2022-04-07 For next time: add a missing wire on LRADC
    [centrale.kicad_pcb]
2022-04-07 Generate pcb support fab file
    [pcb.stl]
2022-04-07 Add real dimensions from printed PCB support.
    [PCB-mesures.dxf]
2022-04-12 Shrink a bit the base, to make sure it fits in the other part
    [display.scad]
2022-04-12 Better LCD support
    [display.scad]
2022-04-12 Add lcd locks
    [display.scad]
2022-04-13 Generate STL fle for LCD support
    [display.scad, display.stl]
2022-04-13 Add lock clips STL
    [display-lock.scad, display-lock.stl, display.scad]
2022-04-14 Ajust locks with real sizes
    [display-lock.scad, display-lock.stl]
2022-04-15 WIP on a littlevg aplication for the LCD. It also gets data from the BME280 and push them to the CAN bus
2022-04-16 Fix SHT20 address (we want the R/W bit inclued now) Make sure RA5 is input
    [main.c]
2022-04-16 Fix pressure/barometer input (we don't strictly follow n2k here to have better resolution)
2022-05-02 Fix connectors mounting holes
    [coupleur-5p.kicad_pcb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]
2023-03-14 update capteur & centrale to new kicad format
    [capteur.kicad_pcb, capteur.kicad_sch, centrale.kicad_pcb, centrale.kicad_sch, coupleur-duallink.kicad_pcb, keys.kicad_pcb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]
2023-03-14 Convert power and vetus to new kicad format
    [power.kicad_pcb, power.kicad_sch, vetus.kicad_pcb, vetus.kicad_sch]
2023-04-15 Name CANH and CANL nets
    [centrale.kicad_pcb, centrale.kicad_sch, lime2.kicad_sch]
2024-07-21 Implement N2K_PRINTF Ignore wind data with overflow Ignore wind data with bad checksums For some reason we get framing errors, and the bit doesn't reset as expected so ignore framing errors
    [main.c]
